bruc3van/agent-buddy-esp32/tools/logo-overrides/README.md

# 官方 logo 覆盖

magpie 的图标来自 lobehub/lobe-icons，个别与官方 logo 不一致，这里放官网原版，`tools/gen_icons.py` 优先使用：

| 文件 | 来源 |
|---|---|
| `pi.svg` | https://pi.dev/logo.svg（Pi 官方，三色像素块） |

ZCode 保持 magpie 原有的大写字母 Z 图标（用户指定）。
