bruc3van/agent-buddy-esp32/docs/images/dupont-hand.jpg

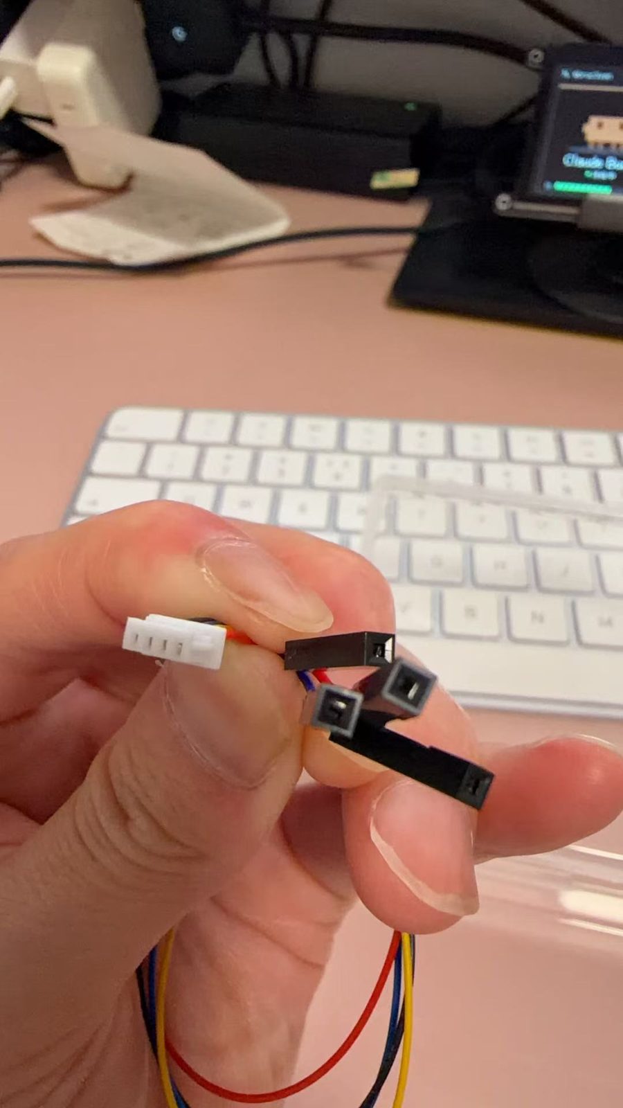
docs/images/dupont-hand.jpg
