bruc3van/agent-buddy-esp32/docs/images/radar-cables.jpg

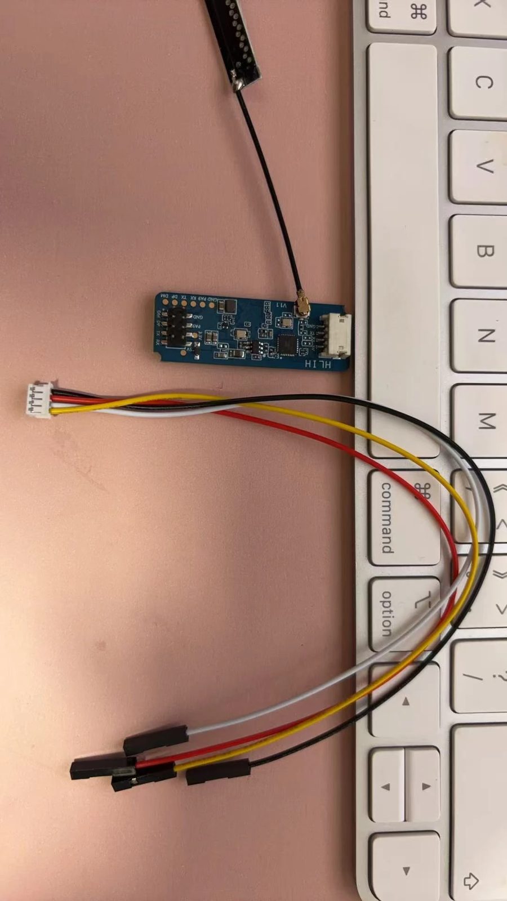
docs/images/radar-cables.jpg
