bruc3van/agent-buddy-esp32/docs/images/v2-magpie-photo.jpg

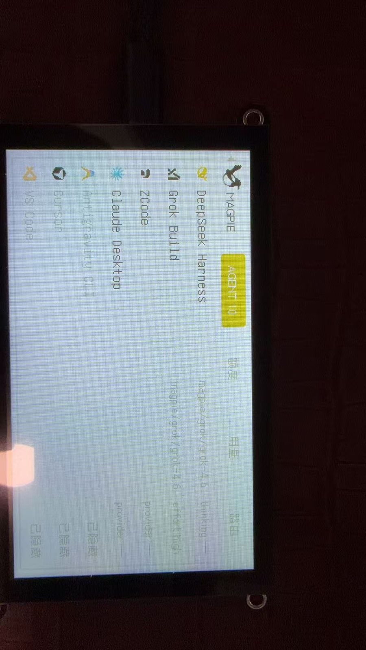
docs/images/v2-magpie-photo.jpg
