bruc3van/agent-buddy-esp32/promo/cover.png

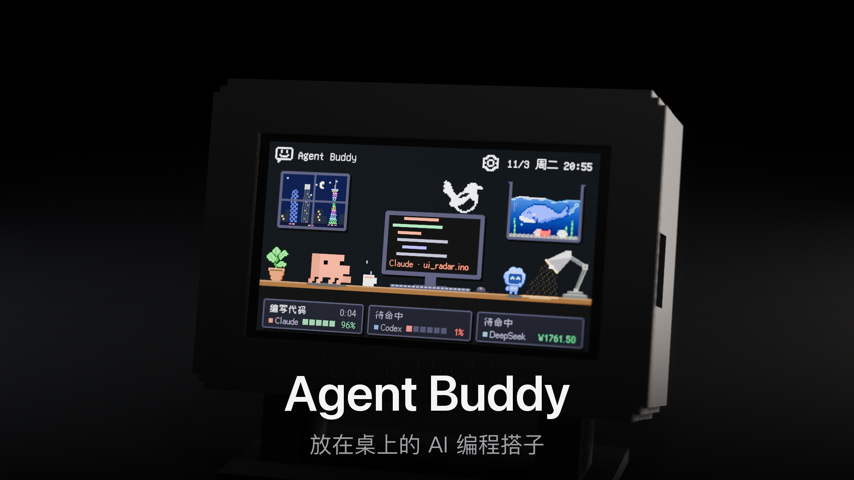
promo/cover.png
