bruc3van/agent-buddy-esp32/case/stl/2-机身-深灰.stl

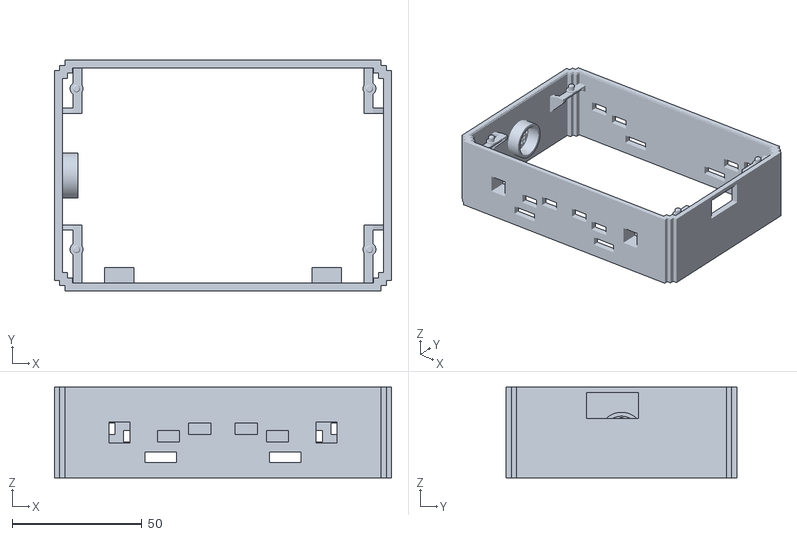
[picture p27: CAD file, 2026-11-05]
case/stl/2-机身-深灰.stl
130.0 x 89.0 x 35.0
