bruc3van/agent-buddy-esp32/case/stl/4-支架-黑.stl

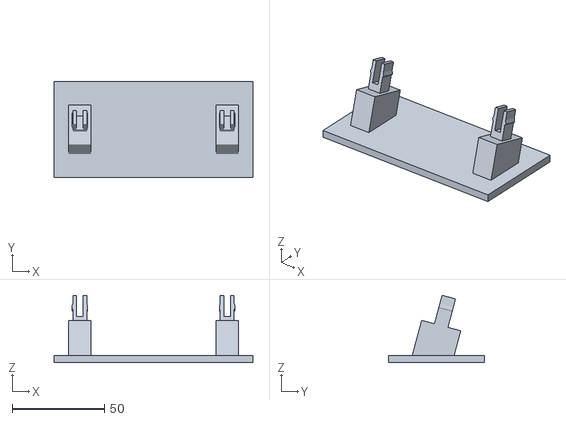
[picture p28: CAD file, 2026-10-31]
case/stl/4-支架-黑.stl
108.0 x 52.0 x 36.6
