bruc3van/agent-buddy-esp32/case/stl/3-后盖-深灰.stl

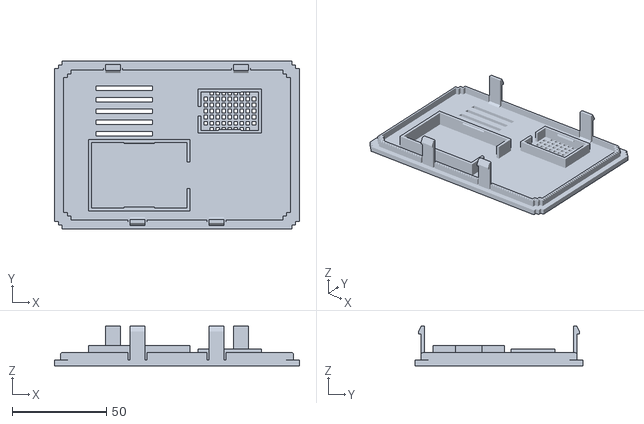
[picture p29: CAD file, 2026-10-31]
case/stl/3-后盖-深灰.stl
130.0 x 89.0 x 21.0
