bruc3van/agent-buddy-esp32/case/stl/1-前框-黑.stl

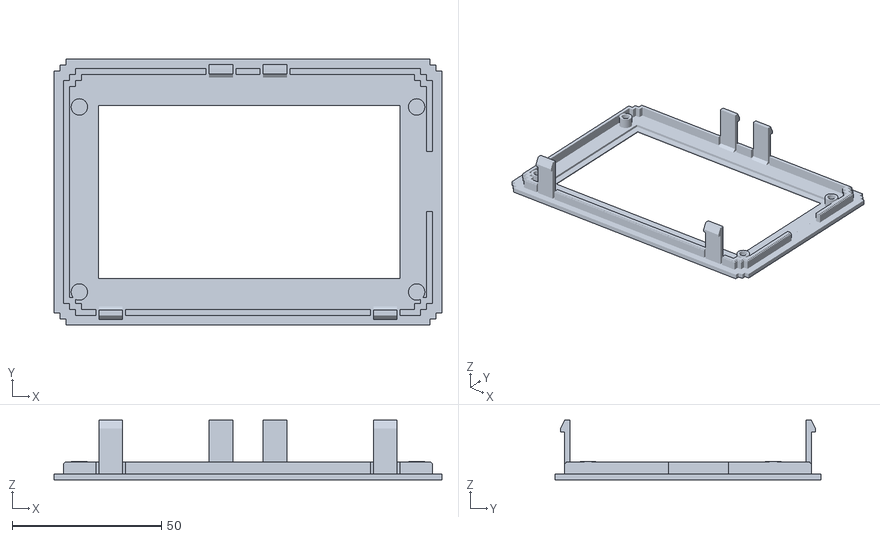
[picture p30: CAD file, 2026-10-31]
case/stl/1-前框-黑.stl
130.0 x 89.0 x 20.0
