bruc3van/agent-buddy-esp32/(list of files, cad)

Other CAD files:
case/外壳预览.blend
