bruc3van/agent-buddy-esp32/case/preview/assembly-back.png

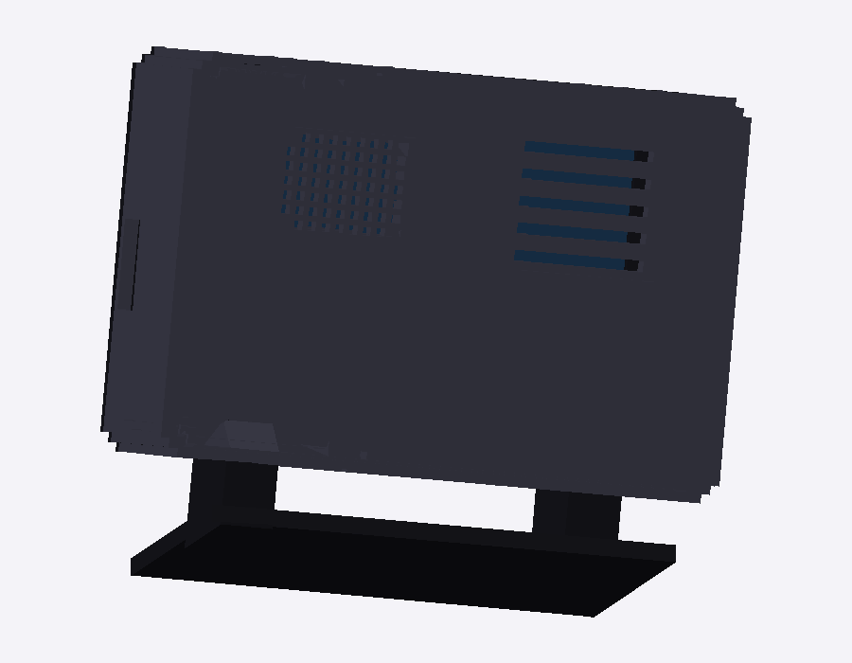
case/preview/assembly-back.png
