bruc3van/agent-buddy-esp32/case/preview/assembly-side.png

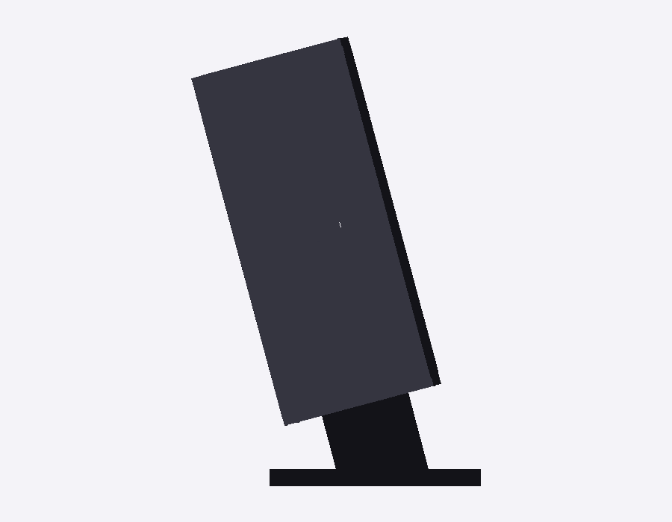
case/preview/assembly-side.png
