bruc3van/agent-buddy-esp32/docs/images/wiring-back.jpg

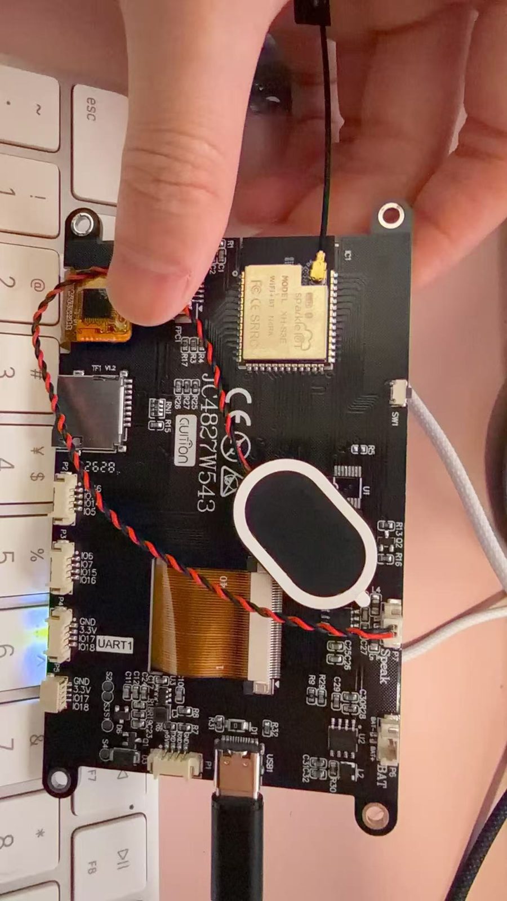
docs/images/wiring-back.jpg
