bruc3van/agent-buddy-esp32/docs/images/wiring-mic.jpg

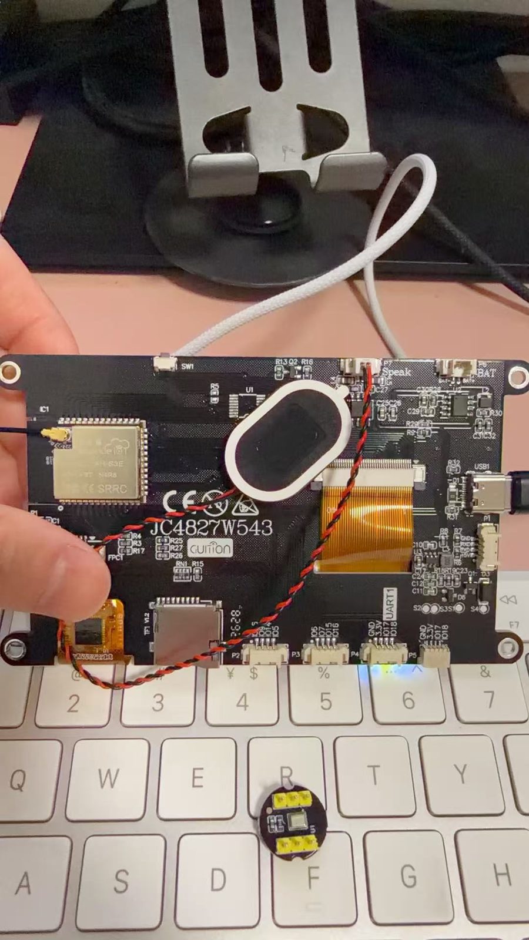
docs/images/wiring-mic.jpg
