bruc3van/agent-buddy-esp32/agent_buddy/QspiFast.cpp

#include "QspiFast.h"

#if defined(ESP32) && (CONFIG_IDF_TARGET_ESP32 || CONFIG_IDF_TARGET_ESP32S2 || CONFIG_IDF_TARGET_ESP32S3 || CONFIG_IDF_TARGET_ESP32C2 || CONFIG_IDF_TARGET_ESP32C3 || CONFIG_IDF_TARGET_ESP32C6 || CONFIG_IDF_TARGET_ESP32H2 || CONFIG_IDF_TARGET_ESP32P4 || CONFIG_IDF_TARGET_ESP32C5)

QspiFast::QspiFast(
    int8_t cs, int8_t sck, int8_t mosi, int8_t miso, int8_t quadwp, int8_t quadhd, bool is_shared_interface /* = false */)
    : _cs(cs), _sck(sck), _mosi(mosi), _miso(miso), _quadwp(quadwp), _quadhd(quadhd), _is_shared_interface(is_shared_interface)
{
}

bool QspiFast::begin(int32_t speed, int8_t dataMode)
{
  // set SPI parameters
  _speed = (speed <= GFX_NOT_DEFINED) ? ESP32QSPI_FREQUENCY : speed;
  _dataMode = (dataMode == GFX_NOT_DEFINED) ? ESP32QSPI_SPI_MODE : dataMode;

  pinMode(_cs, OUTPUT);
  digitalWrite(_cs, HIGH); // disable chip select
#if (CONFIG_IDF_TARGET_ESP32 || CONFIG_IDF_TARGET_ESP32S2 || CONFIG_IDF_TARGET_ESP32S3 || CONFIG_IDF_TARGET_ESP32C6 || CONFIG_IDF_TARGET_ESP32P4 || CONFIG_IDF_TARGET_ESP32C5)
  if (_cs >= 32)
  {
    _csPinMask = digitalPinToBitMask(_cs);
    _csPortSet = (PORTreg_t)GPIO_OUT1_W1TS_REG;
    _csPortClr = (PORTreg_t)GPIO_OUT1_W1TC_REG;
  }
  else if (_cs != GFX_NOT_DEFINED)
  {
    _csPinMask = digitalPinToBitMask(_cs);
    _csPortSet = (PORTreg_t)GPIO_OUT_W1TS_REG;
    _csPortClr = (PORTreg_t)GPIO_OUT_W1TC_REG;
  }
#else
  if (_cs != GFX_NOT_DEFINED)
  {
    _csPinMask = digitalPinToBitMask(_cs);
    _csPortSet = (PORTreg_t)GPIO_OUT_W1TS_REG;
    _csPortClr = (PORTreg_t)GPIO_OUT_W1TC_REG;
  }
#endif

  if (speed != GFX_SKIP_DATABUS_UNDERLAYING_BEGIN)
  {
    spi_bus_config_t buscfg = {
        .mosi_io_num = _mosi,
        .miso_io_num = _miso,
        .sclk_io_num = _sck,
        .quadwp_io_num = _quadwp,
        .quadhd_io_num = _quadhd,
        .data4_io_num = -1,
        .data5_io_num = -1,
        .data6_io_num = -1,
        .data7_io_num = -1,
        .max_transfer_sz = (ESP32QSPI_MAX_PIXELS_AT_ONCE * 16) + 8,
        .flags = SPICOMMON_BUSFLAG_MASTER | SPICOMMON_BUSFLAG_GPIO_PINS,
#if (!defined(ESP_ARDUINO_VERSION_MAJOR)) || (ESP_ARDUINO_VERSION_MAJOR < 3)
    // skip this
#else
        .isr_cpu_id = ESP_INTR_CPU_AFFINITY_AUTO,
#endif
        .intr_flags = 0};
    esp_err_t ret = spi_bus_initialize(ESP32QSPI_SPI_HOST, &buscfg, ESP32QSPI_DMA_CHANNEL);
    if (ret != ESP_OK)
    {
      ESP_ERROR_CHECK(ret);
      return false;
    }
  }

  spi_device_interface_config_t devcfg = {
      .command_bits = 8,
      .address_bits = 24,
      .dummy_bits = 0,
      .mode = (uint8_t)_dataMode,
#if defined(ESP_ARDUINO_VERSION_MAJOR) && ESP_ARDUINO_VERSION_MAJOR >= 3
      .clock_source = SPI_CLK_SRC_DEFAULT,
#endif
      .duty_cycle_pos = 0,
      .cs_ena_pretrans = 0,
      .cs_ena_posttrans = 0,
      .clock_speed_hz = _speed,
      .input_delay_ns = 0,
      .spics_io_num = -1, // avoid use system CS control
      .flags = SPI_DEVICE_HALFDUPLEX,
      .queue_size = 1,
      .pre_cb = nullptr,
      .post_cb = nullptr};
  esp_err_t ret = spi_bus_add_device(ESP32QSPI_SPI_HOST, &devcfg, &_handle);
  if (ret != ESP_OK)
  {
    ESP_ERROR_CHECK(ret);
    return false;
  }

  if (!_is_shared_interface)
  {
    spi_device_acquire_bus(_handle, portMAX_DELAY);
  }

  memset(&_spi_tran_ext, 0, sizeof(_spi_tran_ext));
  _spi_tran = (spi_transaction_t *)&_spi_tran_ext;

  _buffer = (uint8_t *)heap_caps_aligned_alloc(16, ESP32QSPI_MAX_PIXELS_AT_ONCE * 2, MALLOC_CAP_DMA);
  if (!_buffer)
  {
    return false;
  }
  _2nd_buffer = (uint8_t *)heap_caps_aligned_alloc(16, ESP32QSPI_MAX_PIXELS_AT_ONCE * 2, MALLOC_CAP_DMA);
  if (!_2nd_buffer)
  {
    return false;
  }
  for (int i = 0; i < 2; i++)
  {
    _fast[i] = (uint16_t *)heap_caps_aligned_alloc(16, FAST_CHUNK * 2, MALLOC_CAP_DMA | MALLOC_CAP_INTERNAL);
    if (!_fast[i])
    {
      return false;
    }
  }

  return true;
}

void QspiFast::beginWrite()
{
  if (_is_shared_interface)
  {
    spi_device_acquire_bus(_handle, portMAX_DELAY);
  }
}

void QspiFast::endWrite()
{
  if (_is_shared_interface)
  {
    spi_device_release_bus(_handle);
  }
}

void QspiFast::writeCommand(uint8_t c)
{
  CS_LOW();
  _spi_tran_ext.base.flags = SPI_TRANS_MULTILINE_CMD | SPI_TRANS_MULTILINE_ADDR;
  _spi_tran_ext.base.cmd = 0x02;
  _spi_tran_ext.base.addr = ((uint32_t)c) << 8;
  _spi_tran_ext.base.tx_buffer = NULL;
  _spi_tran_ext.base.length = 0;
  POLL_START();
  POLL_END();
  CS_HIGH();
}

void QspiFast::writeCommand16(uint16_t c)
{
  CS_LOW();
  _spi_tran_ext.base.flags = SPI_TRANS_MULTILINE_CMD | SPI_TRANS_MULTILINE_ADDR;
  _spi_tran_ext.base.cmd = 0x02;
  _spi_tran_ext.base.addr = c;
  _spi_tran_ext.base.tx_buffer = NULL;
  _spi_tran_ext.base.length = 0;
  POLL_START();
  POLL_END();
  CS_HIGH();
}

void QspiFast::writeCommandBytes(uint8_t *data, uint32_t len)
{
  CS_LOW();
  uint32_t l;
  while (len)
  {
    l = (len >= (ESP32QSPI_MAX_PIXELS_AT_ONCE << 1)) ? (ESP32QSPI_MAX_PIXELS_AT_ONCE << 1) : len;

    _spi_tran_ext.base.flags = SPI_TRANS_MULTILINE_CMD | SPI_TRANS_MULTILINE_ADDR;
    _spi_tran_ext.base.tx_buffer = data;
    _spi_tran_ext.base.length = l << 3;

    POLL_START();
    POLL_END();

    len -= l;
    data += l;
  }
  CS_HIGH();
}

void QspiFast::write(uint8_t d)
{
  CS_LOW();
  _spi_tran_ext.base.flags = SPI_TRANS_USE_TXDATA | SPI_TRANS_MODE_QIO;
  _spi_tran_ext.base.cmd = 0x32;
  _spi_tran_ext.base.addr = 0x003C00;
  _spi_tran_ext.base.tx_data[0] = d;
  _spi_tran_ext.base.length = 8;
  POLL_START();
  POLL_END();
  CS_HIGH();
}

void QspiFast::write16(uint16_t d)
{
  CS_LOW();
  _spi_tran_ext.base.flags = SPI_TRANS_USE_TXDATA | SPI_TRANS_MODE_QIO;
  _spi_tran_ext.base.cmd = 0x32;
  _spi_tran_ext.base.addr = 0x003C00;
  _spi_tran_ext.base.tx_data[0] = d >> 8;
  _spi_tran_ext.base.tx_data[1] = d;
  _spi_tran_ext.base.length = 16;
  POLL_START();
  POLL_END();
  CS_HIGH();
}

void QspiFast::writeC8D8(uint8_t c, uint8_t d)
{
  CS_LOW();
  _spi_tran_ext.base.flags = SPI_TRANS_USE_TXDATA | SPI_TRANS_MULTILINE_CMD | SPI_TRANS_MULTILINE_ADDR;
  _spi_tran_ext.base.cmd = 0x02;
  _spi_tran_ext.base.addr = ((uint32_t)c) << 8;
  _spi_tran_ext.base.tx_data[0] = d;
  _spi_tran_ext.base.length = 8;
  POLL_START();
  POLL_END();
  CS_HIGH();
}

void QspiFast::writeC8D16(uint8_t c, uint16_t d)
{
  CS_LOW();
  _spi_tran_ext.base.flags = SPI_TRANS_USE_TXDATA | SPI_TRANS_MULTILINE_CMD | SPI_TRANS_MULTILINE_ADDR;
  _spi_tran_ext.base.cmd = 0x02;
  _spi_tran_ext.base.addr = ((uint32_t)c) << 8;
  _spi_tran_ext.base.tx_data[0] = d >> 8;
  _spi_tran_ext.base.tx_data[1] = d;
  _spi_tran_ext.base.length = 16;
  POLL_START();
  POLL_END();
  CS_HIGH();
}

void QspiFast::writeC8D16D16(uint8_t c, uint16_t d1, uint16_t d2)
{
  CS_LOW();
  _spi_tran_ext.base.flags = SPI_TRANS_USE_TXDATA | SPI_TRANS_MULTILINE_CMD | SPI_TRANS_MULTILINE_ADDR;
  _spi_tran_ext.base.cmd = 0x02;
  _spi_tran_ext.base.addr = ((uint32_t)c) << 8;
  _spi_tran_ext.base.tx_data[0] = d1 >> 8;
  _spi_tran_ext.base.tx_data[1] = d1;
  _spi_tran_ext.base.tx_data[2] = d2 >> 8;
  _spi_tran_ext.base.tx_data[3] = d2;
  _spi_tran_ext.base.length = 32;
  POLL_START();
  POLL_END();
  CS_HIGH();
}

void QspiFast::writeC8D16D16Split(uint8_t c, uint16_t d1, uint16_t d2)
{
  CS_LOW();
  _spi_tran_ext.base.flags = SPI_TRANS_USE_TXDATA | SPI_TRANS_MULTILINE_CMD | SPI_TRANS_MULTILINE_ADDR;
  _spi_tran_ext.base.cmd = 0x02;
  _spi_tran_ext.base.addr = ((uint32_t)c) << 8;
  _spi_tran_ext.base.tx_data[0] = d1 >> 8;
  _spi_tran_ext.base.tx_data[1] = d1;
  _spi_tran_ext.base.tx_data[2] = d2 >> 8;
  _spi_tran_ext.base.tx_data[3] = d2;
  _spi_tran_ext.base.length = 32;
  POLL_START();
  POLL_END();
  CS_HIGH();
}

void QspiFast::writeC8Bytes(uint8_t c, uint8_t *data, uint32_t len)
{
  CS_LOW();
  _spi_tran_ext.base.flags = SPI_TRANS_MULTILINE_CMD | SPI_TRANS_MULTILINE_ADDR;
  _spi_tran_ext.base.cmd = 0x02;
  _spi_tran_ext.base.addr = ((uint32_t)c) << 8;
  _spi_tran_ext.base.tx_buffer = data;
  _spi_tran_ext.base.length = len << 3;
  POLL_START();
  POLL_END();
  CS_HIGH();
}

void QspiFast::writeRepeat(uint16_t p, uint32_t len)
{
  bool first_send = true;

  uint16_t bufLen = (len >= ESP32QSPI_MAX_PIXELS_AT_ONCE) ? ESP32QSPI_MAX_PIXELS_AT_ONCE : len;
  int16_t xferLen, l;
  uint32_t c32;
  MSB_32_16_16_SET(c32, p, p);

  l = (bufLen + 1) / 2;
  for (uint32_t i = 0; i < l; i++)
  {
    _buffer32[i] = c32;
  }

  CS_LOW();
  // Issue pixels in blocks from temp buffer
  while (len) // While pixels remain
  {
    xferLen = (bufLen <= len) ? bufLen : len; // How many this pass?

    if (first_send)
    {
      _spi_tran_ext.base.flags = SPI_TRANS_MODE_QIO;
      _spi_tran_ext.base.cmd = 0x32;
      _spi_tran_ext.base.addr = 0x003C00;
      first_send = false;
    }
    else
    {
      _spi_tran_ext.base.flags = SPI_TRANS_MODE_QIO | SPI_TRANS_VARIABLE_CMD |
                                 SPI_TRANS_VARIABLE_ADDR | SPI_TRANS_VARIABLE_DUMMY;
    }
    _spi_tran_ext.base.tx_buffer = _buffer16;
    _spi_tran_ext.base.length = xferLen << 4;

    POLL_START();
    POLL_END();

    len -= xferLen;
  }
  CS_HIGH();
}

// 屏幕校色表（定义在 agent_buddy.ino）：panelGamma == 1 时不校色
extern uint8_t lut5[32], lut6[64];
extern float panelGamma;

// 把一段原生字节序的 RGB565 转成屏幕要的大端序，顺带查表校色；连续同色像素直接复用上一个结果
static void IRAM_ATTR convertChunk(const uint16_t *src, uint16_t *dst, uint32_t n, bool lut)
{
  uint16_t prevIn = src[0] ^ 0xFFFF, prevOut = 0;
  for (uint32_t i = 0; i < n; i++)
  {
    uint16_t c = src[i];
    if (c != prevIn)
    {
      prevIn = c;
      uint16_t o = lut ? (uint16_t)((lut5[c >> 11] << 11) | (lut6[(c >> 5) & 0x3F] << 5) | lut5[c & 0x1F]) : c;
      prevOut = (uint16_t)((o >> 8) | (o << 8));
    }
    dst[i] = prevOut;
  }
}

// 双缓冲异步 DMA：第 k 块在线上发送时，CPU 准备第 k+1 块；块大小 FAST_CHUNK 像素
void QspiFast::writePixels(uint16_t *data, uint32_t len)
{
  CS_LOW();
  bool first = true, inflight = false, lut = panelGamma != 1.0f;
  int cur = 0;
  while (len)
  {
    uint32_t l = len > FAST_CHUNK ? FAST_CHUNK : len;
    convertChunk(data, _fast[cur], l, lut);
    data += l;
    len -= l;
    if (inflight)
    {
      spi_transaction_t *done;
      spi_device_get_trans_result(_handle, &done, portMAX_DELAY);
    }
    spi_transaction_ext_t &t = _fastTr[cur];
    memset(&t, 0, sizeof(t));
    if (first)
    {
      t.base.flags = SPI_TRANS_MODE_QIO;
      t.base.cmd = 0x32;
      t.base.addr = 0x003C00;
      first = false;
    }
    else
    {
      t.base.flags = SPI_TRANS_MODE_QIO | SPI_TRANS_VARIABLE_CMD | SPI_TRANS_VARIABLE_ADDR | SPI_TRANS_VARIABLE_DUMMY;
    }
    t.base.tx_buffer = _fast[cur];
    t.base.length = l << 4;
    spi_device_queue_trans(_handle, (spi_transaction_t *)&t, portMAX_DELAY);
    inflight = true;
    cur ^= 1;
  }
  if (inflight)
  {
    spi_transaction_t *done;
    spi_device_get_trans_result(_handle, &done, portMAX_DELAY);
  }
  CS_HIGH();
}

void QspiFast::batchOperation(const uint8_t *operations, size_t len)
{
  for (size_t i = 0; i < len; ++i)
  {
    uint8_t l = 0;
    switch (operations[i])
    {
    case BEGIN_WRITE:
      beginWrite();
      break;
    case WRITE_COMMAND_8:
      writeCommand(operations[++i]);
      break;
    case WRITE_COMMAND_16:
      _data16.msb = operations[++i];
      _data16.lsb = operations[++i];
      writeCommand16(_data16.value);
      break;
    case WRITE_DATA_8:
      write(operations[++i]);
      break;
    case WRITE_DATA_16:
      _data16.msb = operations[++i];
      _data16.lsb = operations[++i];
      write16(_data16.value);
      break;
    case WRITE_BYTES:
      l = operations[++i];
      memcpy(_buffer, operations + i + 1, l);
      i += l;
      writeBytes(_buffer, l);
      break;
    case WRITE_C8_D8:
      l = operations[++i];
      writeC8D8(l, operations[++i]);
      break;
    case WRITE_C8_D16:
      l = operations[++i];
      _data16.msb = operations[++i];
      _data16.lsb = operations[++i];
      writeC8D16(l, _data16.value);
      break;
    case WRITE_C8_BYTES:
    {
      uint8_t c = operations[++i];
      l = operations[++i];
      memcpy(_buffer, operations + i + 1, l);
      i += l;
      writeC8Bytes(c, _buffer, l);
    }
    break;
    case WRITE_C16_D16:
      break;
    case END_WRITE:
      endWrite();
      break;
    case DELAY:
      delay(operations[++i]);
      break;
    default:
      printf("Unknown operation id at %d: %d\n", i, operations[i]);
      break;
    }
  }
}

void QspiFast::writeBytes(uint8_t *data, uint32_t len)
{
  CS_LOW();
  uint32_t l;
  bool first_send = true;
  while (len)
  {
    l = (len >= (ESP32QSPI_MAX_PIXELS_AT_ONCE << 1)) ? (ESP32QSPI_MAX_PIXELS_AT_ONCE << 1) : len;

    if (first_send)
    {
      _spi_tran_ext.base.flags = SPI_TRANS_MODE_QIO;
      _spi_tran_ext.base.cmd = 0x32;
      _spi_tran_ext.base.addr = 0x003C00;
      first_send = false;
    }
    else
    {
      _spi_tran_ext.base.flags = SPI_TRANS_MODE_QIO | SPI_TRANS_VARIABLE_CMD |
                                 SPI_TRANS_VARIABLE_ADDR | SPI_TRANS_VARIABLE_DUMMY;
    }

    _spi_tran_ext.base.tx_buffer = data;
    _spi_tran_ext.base.length = l << 3;

    POLL_START();
    POLL_END();

    len -= l;
    data += l;
  }
  CS_HIGH();
}

void QspiFast::write16bitBeRGBBitmapR1(uint16_t *bitmap, int16_t w, int16_t h)
{
  if (h > ESP32QSPI_MAX_PIXELS_AT_ONCE)
  {
    log_e("h > ESP32QSPI_MAX_PIXELS_AT_ONCE, h: %d", h);
  }
  else
  {
    CS_LOW();
    uint32_t l = h << 4;
    bool first_send = true;
    uint16_t *p;
    uint16_t *origin_offset = bitmap + ((h - 1) * w);

    for (int16_t i = 0; i < w; i++)
    {
      if (first_send)
      {
        _spi_tran_ext.base.flags = SPI_TRANS_MODE_QIO;
        _spi_tran_ext.base.cmd = 0x32;
        _spi_tran_ext.base.addr = 0x003C00;
        first_send = false;
      }
      else
      {
        POLL_END();
        _spi_tran_ext.base.flags = SPI_TRANS_MODE_QIO | SPI_TRANS_VARIABLE_CMD |
                                   SPI_TRANS_VARIABLE_ADDR | SPI_TRANS_VARIABLE_DUMMY;
      }

      p = origin_offset + i;
      for (int16_t j = 0; j < h; j++)
      {
        _buffer16[j] = *p;
        p -= w;
      }

      _spi_tran_ext.base.tx_buffer = _buffer16;
      _spi_tran_ext.base.length = l;

      POLL_START();
    }
    POLL_END();
    CS_HIGH();
  }
}

void QspiFast::writeIndexedPixels(uint8_t *data, uint16_t *idx, uint32_t len)
{
  CS_LOW();
  uint32_t l, l2;
  uint16_t p1, p2;
  bool first_send = true;
  while (len)
  {
    l = (len > ESP32QSPI_MAX_PIXELS_AT_ONCE) ? ESP32QSPI_MAX_PIXELS_AT_ONCE : len;

    if (first_send)
    {
      _spi_tran_ext.base.flags = SPI_TRANS_MODE_QIO;
      _spi_tran_ext.base.cmd = 0x32;
      _spi_tran_ext.base.addr = 0x003C00;
      first_send = false;
    }
    else
    {
      _spi_tran_ext.base.flags = SPI_TRANS_MODE_QIO | SPI_TRANS_VARIABLE_CMD |
                                 SPI_TRANS_VARIABLE_ADDR | SPI_TRANS_VARIABLE_DUMMY;
    }
    l2 = l >> 1;
    for (uint32_t i = 0; i < l2; ++i)
    {
      p1 = idx[*data++];
      p2 = idx[*data++];
      MSB_32_16_16_SET(_buffer32[i], p1, p2);
    }
    if (l & 1)
    {
      p1 = idx[*data++];
      MSB_16_SET(_buffer16[l - 1], p1);
    }

    _spi_tran_ext.base.tx_buffer = _buffer32;
    _spi_tran_ext.base.length = l << 4;

    POLL_START();
    POLL_END();

    len -= l;
  }
  CS_HIGH();
}

void QspiFast::writeIndexedPixelsDouble(uint8_t *data, uint16_t *idx, uint32_t len)
{
  CS_LOW();
  uint32_t l;
  uint16_t p;
  bool first_send = true;
  while (len)
  {
    l = (len > (ESP32QSPI_MAX_PIXELS_AT_ONCE >> 1)) ? (ESP32QSPI_MAX_PIXELS_AT_ONCE >> 1) : len;

    if (first_send)
    {
      _spi_tran_ext.base.flags = SPI_TRANS_MODE_QIO;
      _spi_tran_ext.base.cmd = 0x32;
      _spi_tran_ext.base.addr = 0x003C00;
      first_send = false;
    }
    else
    {
      _spi_tran_ext.base.flags = SPI_TRANS_MODE_QIO | SPI_TRANS_VARIABLE_CMD |
                                 SPI_TRANS_VARIABLE_ADDR | SPI_TRANS_VARIABLE_DUMMY;
    }
    for (uint32_t i = 0; i < l; ++i)
    {
      p = idx[*data++];
      MSB_32_16_16_SET(_buffer32[i], p, p);
    }

    _spi_tran_ext.base.tx_buffer = _buffer32;
    _spi_tran_ext.base.length = l << 5;

    POLL_START();
    POLL_END();

    len -= l;
  }
  CS_HIGH();
}

void QspiFast::writeYCbCrPixels(uint8_t *yData, uint8_t *cbData, uint8_t *crData, uint16_t w, uint16_t h)
{
  if (w > (ESP32QSPI_MAX_PIXELS_AT_ONCE / 2))
  {
    Arduino_DataBus::writeYCbCrPixels(yData, cbData, crData, w, h);
  }
  else
  {
    bool first_send = true;

    int cols = w >> 1;
    int rows = h >> 1;
    uint8_t *yData2 = yData + w;
    uint16_t *dest = _buffer16;
    uint16_t *dest2 = dest + w;

    uint16_t out_bits = w << 5;

    uint8_t pxCb, pxCr;
    int16_t pxR, pxG, pxB, pxY;

    CS_LOW();
    for (int row = 0; row < rows; ++row)
    {
      for (int col = 0; col < cols; ++col)
      {
        pxCb = *cbData++;
        pxCr = *crData++;
        pxR = CR2R16[pxCr];
        pxG = -CB2G16[pxCb] - CR2G16[pxCr];
        pxB = CB2B16[pxCb];

        pxY = Y2I16[*yData++];
        *dest++ = CLIPRBE[pxY + pxR] | CLIPGBE[pxY + pxG] | CLIPBBE[pxY + pxB];
        pxY = Y2I16[*yData++];
        *dest++ = CLIPRBE[pxY + pxR] | CLIPGBE[pxY + pxG] | CLIPBBE[pxY + pxB];
        pxY = Y2I16[*yData2++];
        *dest2++ = CLIPRBE[pxY + pxR] | CLIPGBE[pxY + pxG] | CLIPBBE[pxY + pxB];
        pxY = Y2I16[*yData2++];
        *dest2++ = CLIPRBE[pxY + pxR] | CLIPGBE[pxY + pxG] | CLIPBBE[pxY + pxB];
      }
      yData += w;
      yData2 += w;

      if (first_send)
      {
        _spi_tran_ext.base.flags = SPI_TRANS_MODE_QIO;
        _spi_tran_ext.base.cmd = 0x32;
        _spi_tran_ext.base.addr = 0x003C00;
        first_send = false;
      }
      else
      {
        POLL_END();
        _spi_tran_ext.base.flags = SPI_TRANS_MODE_QIO | SPI_TRANS_VARIABLE_CMD |
                                   SPI_TRANS_VARIABLE_ADDR | SPI_TRANS_VARIABLE_DUMMY;
      }

      if (row & 1)
      {
        _spi_tran_ext.base.tx_buffer = _2nd_buffer32;
        dest = _buffer16;
      }
      else
      {
        _spi_tran_ext.base.tx_buffer = _buffer32;
        dest = _2nd_buffer16;
      }
      _spi_tran_ext.base.length = out_bits;

      POLL_START();
      dest2 = dest + w;
    }
    POLL_END();
    CS_HIGH();
  }
}
/******** low level bit twiddling **********/

GFX_INLINE void QspiFast::CS_HIGH(void)
{
  *_csPortSet = _csPinMask;
}

GFX_INLINE void QspiFast::CS_LOW(void)
{
  *_csPortClr = _csPinMask;
}

GFX_INLINE void QspiFast::POLL_START()
{
  spi_device_polling_start(_handle, _spi_tran, portMAX_DELAY);
}

GFX_INLINE void QspiFast::POLL_END()
{
  spi_device_polling_end(_handle, portMAX_DELAY);
}

#endif // #if defined(ESP32) && (CONFIG_IDF_TARGET_ESP32 || CONFIG_IDF_TARGET_ESP32S2 || CONFIG_IDF_TARGET_ESP32S3 || CONFIG_IDF_TARGET_ESP32C2 || CONFIG_IDF_TARGET_ESP32C3 || CONFIG_IDF_TARGET_ESP32C6 || CONFIG_IDF_TARGET_ESP32H2 || CONFIG_IDF_TARGET_ESP32P4 || CONFIG_IDF_TARGET_ESP32C5)
