bruc3van/agent-buddy-esp32/agent_buddy/brand_icons.h

// 由 tools/gen_icons.py 生成：magpie 的 Agent / 订阅图标（16px 像素）与 logo 主题色
#pragma once
#include <Arduino.h>

#define BRAND_ICON_SIZE 16
struct BrandIcon { const char *icon; uint16_t color; bool mono; const uint16_t *px; const uint8_t *mask; };
struct BrandAlias { const char *name; const char *icon; };  // Agent 显示名 → 图标名

const uint16_t ic_air_px[256] PROGMEM = {0,0,0,0,0,0,0,0,0,0,0,0,0,0,0,0,0,0,0,0,0,0,0,0,0,0,0,0,0,0,0,0,0,0,0,0,0,0,0,0,0,0,0,0,0,0,0,0,0,0,0,0,0,0,0,0,0,0,0,0,0,0,0,0,0,0,0,0,0,0,0,0,61310,0,0,0,0,0,0,0,0,0,0,0,0,0,0,0,0,0,0,0,0,0,0,0,0,0,61310,61310,0,0,61310,61310,61310,0,0,0,0,61310,0,0,0,0,61310,61310,61310,61310,61310,61310,61310,0,0,61310,61310,61310,61310,61310,0,0,0,0,61310,61310,0,0,61310,0,0,61310,61310,0,0,61310,0,61310,61310,61310,61310,61310,0,0,61310,0,0,61310,61310,0,0,0,61310,61310,0,0,61310,61310,0,0,61310,61310,0,61310,61310,0,0,0,0,0,61310,61310,61310,61310,61310,61310,61310,61310,61310,61310,61310,61310,61310,0,0,0,0,0,0,0,0,0,0,0,0,0,0,0,0,0,0,0,0,0,0,0,0,0,0,0,0,0,0,0,0,0,0,0,0,0,0,0,0,0,0,0,0,0,0,0,0,0,0,0,0,0,0,0,0,0,0,0,0,0,0,0,0,0};
const uint8_t ic_air_mask[32] PROGMEM = {0,0,0,0,0,0,0,0,0,128,0,0,51,132,63,159,12,153,124,152,204,216,63,254,0,0,0,0,0,0,0,0};
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
const uint8_t ic_zed_mask[32] PROGMEM = {255,255,128,2,128,4,159,248,144,17,147,225,151,201,144,137,145,9,147,105,135,201,136,9,31,249,32,1,64,1,255,255};
const uint16_t ic_zhipu_color_px[256] PROGMEM = {0,0,0,0,0,0,0,0,0,0,0,0,0,0,0,0,0,0,0,0,0,0,0,0,0,0,0,0,0,0,0,0,0,0,0,0,0,0,0,15071,15071,0,0,0,0,0,0,0,0,0,0,0,0,0,0,0,0,0,0,0,0,0,0,0,0,0,0,0,0,15071,15135,0,0,17215,13023,0,0,0,0,0,0,0,0,13023,0,13023,15071,0,0,13023,13023,0,15071,0,0,0,0,0,0,0,0,0,0,15071,0,0,0,0,0,0,0,0,0,0,0,15071,15103,0,0,15135,15135,0,0,15103,13023,0,0,0,0,0,0,13023,15103,0,0,15135,15135,0,0,15103,15071,0,0,0,0,0,0,0,0,0,0,15103,0,0,0,0,0,0,0,0,0,0,0,15071,0,13023,15071,0,0,15103,15071,0,15071,0,0,0,0,0,0,0,0,13023,17215,0,0,17215,15071,0,0,0,0,0,0,0,0,0,0,0,0,0,0,0,0,0,0,0,0,0,0,0,0,0,0,0,0,15071,13023,0,0,0,0,0,0,0,0,0,0,0,0,0,0,0,0,0,0,0,0,0,0,0,0,0,0,0,0,0,0,0,0,0,0,0,0,0,0,0};
const uint8_t ic_zhipu_color_mask[32] PROGMEM = {0,0,0,0,1,128,0,0,6,96,22,104,1,0,25,152,25,152,1,0,22,104,6,96,0,0,1,128,0,0,0,0};

const BrandIcon BRAND_ICONS[59] = {
  {"air", 61310, true, ic_air_px, ic_air_mask},
  {"alma", 61310, true, ic_alma_px, ic_alma_mask},
  {"anthropic", 61310, true, ic_anthropic_px, ic_anthropic_mask},
  {"antigravity-color", 15454, false, ic_antigravity_color_px, ic_antigravity_color_mask},
  {"aside", 61310, true, ic_aside_px, ic_aside_mask},
  {"astrbot", 11319, false, ic_astrbot_px, ic_astrbot_mask},
  {"atomcode", 19582, false, ic_atomcode_px, ic_atomcode_mask},
  {"cindy", 53413, false, ic_cindy_px, ic_cindy_mask},
  {"claude-color", 56234, false, ic_claude_color_px, ic_claude_color_mask},
  {"claudecode-color", 56234, false, ic_claudecode_color_px, ic_claudecode_color_mask},
  {"cline", 61310, true, ic_cline_px, ic_cline_mask},
  {"codebuddy-color", 27263, false, ic_codebuddy_color_px, ic_codebuddy_color_mask},
  {"codex-color", 29791, false, ic_codex_color_px, ic_codex_color_mask},
  {"commandcode", 61310, true, ic_commandcode_px, ic_commandcode_mask},
  {"copilot-color", 7388, false, ic_copilot_color_px, ic_copilot_color_mask},
  {"crush", 60029, false, ic_crush_px, ic_crush_mask},
  {"curl", 61310, true, ic_curl_px, ic_curl_mask},
  {"cursor", 61310, true, ic_cursor_px, ic_cursor_mask},
  {"deepseek-color", 19295, false, ic_deepseek_color_px, ic_deepseek_color_mask},
  {"devin", 61310, true, ic_devin_px, ic_devin_mask},
  {"empryo-color", 13103, false, ic_empryo_color_px, ic_empryo_color_mask},
  {"factory", 61310, true, ic_factory_px, ic_factory_mask},
  {"fx", 61310, true, ic_fx_px, ic_fx_mask},
  {"gemini-color", 13375, false, ic_gemini_color_px, ic_gemini_color_mask},
  {"geminicli-color", 9149, false, ic_geminicli_color_px, ic_geminicli_color_mask},
  {"githubcopilot", 61310, true, ic_githubcopilot_px, ic_githubcopilot_mask},
  {"goose", 61310, true, ic_goose_px, ic_goose_mask},
  {"grok", 61310, true, ic_grok_px, ic_grok_mask},
  {"hanako", 61310, true, ic_hanako_px, ic_hanako_mask},
  {"hermes", 61310, true, ic_hermes_px, ic_hermes_mask},
  {"jcode", 61310, true, ic_jcode_px, ic_jcode_mask},
  {"kimi", 61310, true, ic_kimi_px, ic_kimi_mask},
  {"lody", 8851, false, ic_lody_px, ic_lody_mask},
  {"magpie", 61310, true, ic_magpie_px, ic_magpie_mask},
  {"meta-color", 1055, false, ic_meta_color_px, ic_meta_color_mask},
  {"mimocode", 61310, true, ic_mimocode_px, ic_mimocode_mask},
  {"minimax-color", 61963, false, ic_minimax_color_px, ic_minimax_color_mask},
  {"mistermorph-color", 15254, false, ic_mistermorph_color_px, ic_mistermorph_color_mask},
  {"moonshot", 61310, true, ic_moonshot_px, ic_moonshot_mask},
  {"mothx", 716, false, ic_mothx_px, ic_mothx_mask},
  {"omo", 61310, true, ic_omo_px, ic_omo_mask},
  {"omp", 61310, true, ic_omp_px, ic_omp_mask},
  {"openai", 61310, true, ic_openai_px, ic_openai_mask},
  {"openchamber", 61310, true, ic_openchamber_px, ic_openchamber_mask},
  {"opencode", 61310, true, ic_opencode_px, ic_opencode_mask},
  {"pi", 62608, false, ic_pi_px, ic_pi_mask},
  {"prime-agent", 61310, true, ic_prime_agent_px, ic_prime_agent_mask},
  {"qoder", 61310, true, ic_qoder_px, ic_qoder_mask},
  {"qwen-color", 27293, false, ic_qwen_color_px, ic_qwen_color_mask},
  {"raycast", 61310, true, ic_raycast_px, ic_raycast_mask},
  {"reasonix-color", 44137, false, ic_reasonix_color_px, ic_reasonix_color_mask},
  {"snow", 61310, true, ic_snow_px, ic_snow_mask},
  {"stepfun-color", 1151, false, ic_stepfun_color_px, ic_stepfun_color_mask},
  {"t3code", 61310, true, ic_t3code_px, ic_t3code_mask},
  {"vscode", 985, false, ic_vscode_px, ic_vscode_mask},
  {"xai", 61310, true, ic_xai_px, ic_xai_mask},
  {"zcode", 61310, true, ic_zcode_px, ic_zcode_mask},
  {"zed", 61310, true, ic_zed_px, ic_zed_mask},
  {"zhipu-color", 15071, false, ic_zhipu_color_px, ic_zhipu_color_mask},
};
const BrandAlias BRAND_ALIAS[60] = {
  {"Alma", "alma"},
  {"Antigravity CLI", "antigravity-color"},
  {"Aside", "aside"},
  {"AstrBot", "astrbot"},
  {"AtomCode", "atomcode"},
  {"Cindy", "cindy"},
  {"Claude Code", "claudecode-color"},
  {"Claude Desktop", "claude-color"},
  {"Cline", "cline"},
  {"CodeBuddy Code", "codebuddy-color"},
  {"Codex", "codex-color"},
  {"Command Code", "commandcode"},
  {"Copilot (JetBrains)", "githubcopilot"},
  {"Copilot CLI", "githubcopilot"},
  {"Crush", "crush"},
  {"Cursor", "cursor"},
  {"DeepSeek Harness", "deepseek-color"},
  {"Devin", "devin"},
  {"Droid", "factory"},
  {"Empryo", "empryo-color"},
  {"Gemini CLI", "geminicli-color"},
  {"Goose", "goose"},
  {"Grok App", "grok"},
  {"Grok Build", "xai"},
  {"Hermes Agent", "hermes"},
  {"JetBrains Air", "air"},
  {"Kimi Code", "kimi"},
  {"Lody", "lody"},
  {"MiMo Code", "mimocode"},
  {"MiniMax Code", "minimax-color"},
  {"Mister Morph", "mistermorph-color"},
  {"MothX", "mothx"},
  {"Muse Code", "meta-color"},
  {"OmO", "omo"},
  {"OpenChamber", "openchamber"},
  {"OpenCode", "opencode"},
  {"OpenHanako", "hanako"},
  {"PI-Desktop", "pi"},
  {"Pi", "pi"},
  {"Prime Agent", "prime-agent"},
  {"Qoder", "qoder"},
  {"Qwen Code", "qwen-color"},
  {"Raycast", "raycast"},
  {"Reasonix", "reasonix-color"},
  {"Reasonix Studio", "reasonix-color"},
  {"Snow CLI", "snow"},
  {"StepCode", "stepfun-color"},
  {"T3 Code", "t3code"},
  {"VS Code", "vscode"},
  {"VS Code Insiders", "vscode"},
  {"ZCode", "zcode"},
  {"Zed", "zed"},
  {"config.yaml", "goose"},
  {"crush.json", "crush"},
  {"curl", "curl"},
  {"fx", "fx"},
  {"jcode", "jcode"},
  {"magpie", "magpie"},
  {"omp", "omp"},
  {"repl", "aside"},
};
