bruc3van/agent-buddy-esp32/agent_buddy/magpie_wag.h

// 由 tools/gen_wag.py 生成：magpie logo 的 wag 动画（bird-bob / wing-flap / tail-flick），来自 magpie（MIT）
#pragma once
#include <Arduino.h>

#define WAG28_SIZE 28
#define WAG28_FRAMES 23
const uint8_t wag28[23][196] PROGMEM = {
  {0,0,0,0,0,0,0,0,0,0,0,0,0,0,0,0,0,0,0,0,0,16,0,0,0,0,0,0,121,0,0,0,1,148,0,63,64,0,0,31,254,0,175,128,0,0,63,255,228,187,208,0,0,191,255,233,63,240,0,1,255,254,0,111,244,0,2,255,254,0,123,252,0,11,171,254,0,31,254,0,100,3,255,0,2,255,129,128,6,255,64,0,127,253,0,29,255,128,0,47,244,6,244,191,128,0,10,229,191,224,47,128,0,6,255,255,128,1,128,0,11,255,254,0,1,64,0,31,255,228,0,1,0,0,43,254,64,0,1,0,0,6,164,0,0,4,0,0,0,40,0,0,20,0,0,0,9,0,0,80,0,0,0,1,144,5,0,0,0,0,0,22,144,0,0,0,0,0,0,0,0,0,0,0,0,0,0,0,0,0,0,0,0,0,0,0},
  {0,0,0,0,0,0,0,0,0,0,0,0,0,0,0,0,0,0,0,0,0,36,0,0,0,0,0,0,46,0,0,0,6,144,0,47,128,0,0,47,253,0,111,208,0,0,191,255,228,123,224,0,0,255,255,148,46,240,0,2,255,253,0,175,248,0,7,255,253,0,62,252,0,27,175,253,0,31,190,0,100,7,255,0,2,255,65,64,11,255,64,0,191,233,0,105,255,128,0,47,245,107,240,191,128,0,15,255,255,208,47,128,0,31,255,254,0,1,64,0,127,255,244,0,1,64,0,107,254,64,0,2,0,0,1,144,0,0,1,0,0,5,84,0,0,4,0,0,0,116,0,0,16,0,0,0,9,0,0,80,0,0,0,1,80,5,0,0,0,0,0,21,144,0,0,0,0,0,0,0,0,0,0,0,0,0,0,0,0,0,0,0,0,0,0,0},
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
};

#define WAG100_SIZE 100
#define WAG100_FRAMES 23
const uint8_t wag100[23][2500] PROGMEM = {
  {0,0,0,0,0,0,0,0,0,0,0,0,0,0,0,0,0,0,0,0,0,0,0,0,0,0,0,0,0,0,0,0,0,0,0,0,0,0,0,0,0,0,0,0,0,0,0,0,0,0,0,0,0,0,0,0,0,0,0,0,0,0,0,0,0,0,0,0,0,0,0,0,0,0,0,0,0,0,0,0,0,0,0,0,0,0,0,0,0,0,0,0,0,0,0,0,0,0,0,0,0,0,0,0,0,0,0,0,0,0,0,0,0,0,0,0,0,0,0,0,0,0,0,0,0,0,0,0,0,0,0,0,0,0,0,0,0,0,0,0,0,0,0,0,0,0,0,0,0,0,0,0,0,0,0,0,0,0,0,0,0,0,0,0,0,0,0,0,0,0,0,0,0,0,0,0,0,0,0,0,0,0,0,0,0,0,0,0,0,0,0,0,0,0,0,0,0,0,0,0,0,0,0,0,0,0,0,0,0,0,0,0,0,0,0,0,0,0,0,0,0,0,0,0,0,0,0,0,0,0,0,0,0,0,0,0,0,0,0,0,0,0,0,0,0,0,0,0,0,0,0,0,0,0,0,0,0,0,0,0,0,0,0,0,0,0,0,0,0,0,0,0,0,0,0,0,0,0,0,0,0,0,0,0,0,0,0,0,0,0,0,0,0,0,0,0,0,0,0,0,1,64,0,0,0,0,0,0,0,0,0,0,0,0,0,0,0,0,0,0,0,0,0,0,0,3,248,0,0,0,0,0,0,0,0,0,0,0,0,0,0,0,0,0,0,0,0,0,0,0,7,255,128,0,0,0,0,0,0,0,0,0,0,0,0,0,0,0,0,0,0,0,0,0,0,7,255,228,0,0,0,0,0,0,0,0,0,0,0,0,0,0,1,85,0,0,0,0,0,0,7,255,253,0,0,0,0,0,0,0,0,0,0,0,0,0,0,175,255,249,0,0,0,0,0,7,255,255,64,0,0,0,0,0,0,0,0,0,0,0,0,11,255,255,255,208,0,0,0,0,3,255,255,224,0,0,0,0,0,0,0,0,0,0,0,0,127,255,255,255,248,0,0,0,0,2,255,255,244,0,0,0,0,0,0,0,0,0,0,0,2,255,255,255,255,255,64,0,0,0,1,255,255,253,0,0,0,0,0,0,0,0,0,0,0,11,255,255,255,255,255,208,0,0,0,0,191,255,255,64,0,0,0,0,0,0,0,0,0,0,31,255,255,255,255,255,249,0,0,0,40,63,255,255,128,0,0,0,0,0,0,0,0,0,0,127,255,255,255,255,255,255,249,64,0,46,31,255,255,224,0,0,0,0,0,0,0,0,0,0,255,255,255,255,255,255,255,255,249,0,47,139,255,255,244,0,0,0,0,0,0,0,0,0,1,255,255,255,255,255,255,255,255,255,144,47,226,255,255,252,0,0,0,0,0,0,0,0,0,3,255,255,255,255,255,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
0,0,0,0,0,0,0,0,0,0,0,0,0,0,0,0,0,0,0,0,0,0,0,0,0,0,0,0,0,0,0,0,0,0,0,0,0,0,0,0,0,0,0,0,0,0,0,0,0,0,0,0,0,0,0,0,0,0,0,0,0,0,0,0,0,0,0,0,0,0,0,0,0,0,0,0,0,0,0,0,0,0,0,0,0,0,0,0,0,0,0,0,0,0,0,0,0,0,0,0,0,0,0,0,0,0,0,0,0,0,0,0,0,0,0,0,0,0,0,0,0,0,0,0,0,0,0,0,0,0,0,0,0,0,0,0,0,0,0,0,0,0,0,0,0,0,0,0,0,0,0,0,0,0,0,0,0,0,0,0,0,0,0,0,0,0,0,0,0,0,0,0,0,0,0,0,0,0,0,0,0,0,0},
  {0,0,0,0,0,0,0,0,0,0,0,0,0,0,0,0,0,0,0,0,0,0,0,0,0,0,0,0,0,0,0,0,0,0,0,0,0,0,0,0,0,0,0,0,0,0,0,0,0,0,0,0,0,0,0,0,0,0,0,0,0,0,0,0,0,0,0,0,0,0,0,0,0,0,0,0,0,0,0,0,0,0,0,0,0,0,0,0,0,0,0,0,0,0,0,0,0,0,0,0,0,0,0,0,0,0,0,0,0,0,0,0,0,0,0,0,0,0,0,0,0,0,0,0,0,0,0,0,0,0,0,0,0,0,0,0,0,0,0,0,0,0,0,0,0,0,0,0,0,0,0,0,0,0,0,0,0,0,0,0,0,0,0,0,0,0,0,0,0,0,0,0,0,0,0,0,0,0,0,0,0,0,0,0,0,0,0,0,0,0,0,0,0,0,0,0,0,0,0,0,0,0,0,0,0,0,0,0,0,0,0,0,0,0,0,0,0,0,0,0,0,0,0,0,0,0,0,0,0,0,0,0,0,0,0,0,0,0,0,0,0,0,0,0,0,0,0,0,0,0,0,0,0,0,0,0,0,0,0,0,0,0,0,0,0,0,0,0,0,0,0,0,0,0,0,0,36,0,0,0,0,0,0,0,0,0,0,0,0,0,0,0,0,0,0,0,0,0,0,0,0,191,64,0,0,0,0,0,0,0,0,0,0,0,0,0,0,0,0,0,0,0,0,0,0,0,191,224,0,0,0,0,0,0,0,0,0,0,0,0,0,0,0,0,0,0,0,0,0,0,0,191,253,0,0,0,0,0,0,0,0,0,0,0,0,0,0,0,0,0,0,0,0,0,0,0,255,255,64,0,0,0,0,0,0,0,0,0,0,0,0,0,26,165,64,0,0,0,0,0,0,255,255,208,0,0,0,0,0,0,0,0,0,0,0,0,6,255,255,248,0,0,0,0,0,0,191,255,244,0,0,0,0,0,0,0,0,0,0,0,0,127,255,255,255,64,0,0,0,0,0,127,255,253,0,0,0,0,0,0,0,0,0,0,0,2,255,255,255,255,244,0,0,0,0,0,63,255,255,0,0,0,0,0,0,0,0,0,0,0,15,255,255,255,255,253,0,0,0,0,4,47,255,255,128,0,0,0,0,0,0,0,0,0,0,47,255,255,255,255,255,128,0,0,0,10,15,255,255,208,0,0,0,0,0,0,0,0,0,0,191,255,255,255,255,255,250,80,0,0,11,135,255,255,240,0,0,0,0,0,0,0,0,0,2,255,255,255,255,255,255,255,255,144,0,11,226,255,255,248,0,0,0,0,0,0,0,0,0,3,255,255,255,255,255,255,255,255,253,0,15,249,255,255,253,0,0,0,0,0,0,0,0,0,11,255,255,255,255,255,255,255,255,255,128,11,254,127,255,254,0,0,0,0,0,0,0,0,0,31,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
,0,0,0,0,0,0,0,0,0,0,0,0,0,0,0,0,0,0,0,0,0,0,0,0,0,0,0,0,0,0,0,0,0,0,0,0,0,0,0,0,0,0,0,0,0,0,0,0,0,0,0,0,0,0,0,0,0,0,0,0,0,0,0,0,0,0,0,0,0,0,0,0,0,0,0,0,0,0,0,0,0,0,0,0,0,0,0,0,0,0,0,0,0,0,0,0,0,0,0,0,0,0,0,0,0,0,0,0,0,0,0,0,0,0,0,0,0,0,0,0,0,0,0,0,0,0,0,0,0,0,0,0,0,0,0,0,0,0,0,0,0,0,0,0,0,0,0,0,0,0,0,0,0,0,0,0,0,0,0,0,0,0,0,0,0,0,0,0,0,0,0,0,0,0,0},
  {0,0,0,0,0,0,0,0,0,0,0,0,0,0,0,0,0,0,0,0,0,0,0,0,0,0,0,0,0,0,0,0,0,0,0,0,0,0,0,0,0,0,0,0,0,0,0,0,0,0,0,0,0,0,0,0,0,0,0,0,0,0,0,0,0,0,0,0,0,0,0,0,0,0,0,0,0,0,0,0,0,0,0,0,0,0,0,0,0,0,0,0,0,0,0,0,0,0,0,0,0,0,0,0,0,0,0,0,0,0,0,0,0,0,0,0,0,0,0,0,0,0,0,0,0,0,0,0,0,0,0,0,0,0,0,0,0,0,0,0,0,0,0,0,0,0,0,0,0,0,0,0,0,0,0,0,0,0,0,0,0,0,0,0,0,0,0,0,0,0,0,0,0,0,0,0,0,0,0,0,0,0,0,0,0,0,0,0,0,0,0,0,0,0,0,0,0,0,0,0,0,0,0,0,0,0,0,0,0,0,0,0,0,0,0,0,0,0,0,0,0,0,0,0,0,0,0,0,0,0,0,0,0,0,0,0,0,0,0,0,0,0,0,0,0,0,0,0,0,0,0,2,208,0,0,0,0,0,0,0,0,0,0,0,0,0,0,0,0,0,0,0,0,0,0,0,3,249,0,0,0,0,0,0,0,0,0,0,0,0,0,0,0,0,0,0,0,0,0,0,0,7,255,64,0,0,0,0,0,0,0,0,0,0,0,0,0,0,0,0,0,0,0,0,0,0,11,255,208,0,0,0,0,0,0,0,0,0,0,0,0,0,0,0,0,0,0,0,0,0,0,11,255,244,0,0,0,0,0,0,0,0,0,0,0,0,0,4,0,0,0,0,0,0,0,0,11,255,253,0,0,0,0,0,0,0,0,0,0,0,0,6,255,249,0,0,0,0,0,0,0,11,255,255,0,0,0,0,0,0,0,0,0,0,0,1,191,255,255,224,0,0,0,0,0,0,7,255,255,128,0,0,0,0,0,0,0,0,0,0,11,255,255,255,253,0,0,0,0,0,0,3,255,255,224,0,0,0,0,0,0,0,0,0,0,127,255,255,255,255,144,0,0,0,0,0,146,255,255,244,0,0,0,0,0,0,0,0,0,1,255,255,255,255,255,244,0,0,0,0,0,240,255,255,248,0,0,0,0,0,0,0,0,0,7,255,255,255,255,255,254,85,0,0,0,1,248,191,255,253,0,0,0,0,0,0,0,0,0,11,255,255,255,255,255,255,255,233,0,0,1,254,63,255,254,0,0,0,0,0,0,0,0,0,47,255,255,255,255,255,255,255,255,208,0,1,255,111,255,255,64,0,0,0,0,0,0,0,0,63,255,255,255,255,255,255,255,255,253,0,1,255,207,255,255,128,0,0,0,0,0,0,0,0,191,255,255,255,255,255,255,255,255,164,0,0,255,231,255,255,192,0,0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
,0,0,0,0,0,0,0,0,0,0,0,0,0,0,0,0,0,0,0,0,0,0,0,0,0,0,0,0,0,0,0,0,0,0,0,0,0,0,0,0,0,0,0,0,0,0,0,0,0,0,0,0,0,0,0,0,0,0,0,0,0,0,0,0,0,0,0,0,0,0,0,0,0,0,0,0,0,0,0,0,0,0,0,0,0,0,0,0,0,0,0,0,0,0,0,0,0,0,0,0,0,0,0,0,0,0,0,0,0,0,0,0,0,0,0,0,0,0,0,0,0,0,0,0,0,0,0,0,0,0,0,0,0,0,0,0,0,0,0,0,0,0,0,0,0,0,0,0,0,0,0,0,0,0,0,0,0,0,0,0,0,0,0,0,0,0,0,0,0},
  {0,0,0,0,0,0,0,0,0,0,0,0,0,0,0,0,0,0,0,0,0,0,0,0,0,0,0,0,0,0,0,0,0,0,0,0,0,0,0,0,0,0,0,0,0,0,0,0,0,0,0,0,0,0,0,0,0,0,0,0,0,0,0,0,0,0,0,0,0,0,0,0,0,0,0,0,0,0,0,0,0,0,0,0,0,0,0,0,0,0,0,0,0,0,0,0,0,0,0,0,0,0,0,0,0,0,0,0,0,0,0,0,0,0,0,0,0,0,0,0,0,0,0,0,0,0,0,0,0,0,0,0,0,0,0,0,0,0,0,0,0,0,0,0,0,0,0,0,0,0,0,0,0,0,0,0,0,0,0,0,0,0,0,0,0,0,0,0,0,0,0,0,0,0,0,0,0,0,0,0,0,0,0,0,0,0,0,0,0,0,0,0,0,0,0,0,0,0,0,0,0,0,0,0,0,0,0,0,0,0,0,0,0,0,0,0,0,0,0,0,0,0,0,0,0,0,0,16,0,0,0,0,0,0,0,0,0,0,0,0,0,0,0,0,0,0,0,0,0,0,0,0,189,0,0,0,0,0,0,0,0,0,0,0,0,0,0,0,0,0,0,0,0,0,0,0,0,255,128,0,0,0,0,0,0,0,0,0,0,0,0,0,0,0,0,0,0,0,0,0,0,1,255,224,0,0,0,0,0,0,0,0,0,0,0,0,0,0,0,0,0,0,0,0,0,0,2,255,248,0,0,0,0,0,0,0,0,0,0,0,0,0,0,0,0,0,0,0,0,0,0,2,255,254,0,0,0,0,0,0,0,0,0,0,0,0,0,85,0,0,0,0,0,0,0,0,2,255,255,64,0,0,0,0,0,0,0,0,0,0,0,111,255,249,0,0,0,0,0,0,0,2,255,255,208,0,0,0,0,0,0,0,0,0,0,7,255,255,255,208,0,0,0,0,0,0,0,255,255,224,0,0,0,0,0,0,0,0,0,0,47,255,255,255,249,0,0,0,0,0,0,16,255,255,248,0,0,0,0,0,0,0,0,0,1,255,255,255,255,255,64,0,0,0,0,0,120,127,255,252,0,0,0,0,0,0,0,0,0,7,255,255,255,255,255,224,0,0,0,0,0,125,63,255,254,0,0,0,0,0,0,0,0,0,15,255,255,255,255,255,255,169,64,0,0,0,191,47,255,255,0,0,0,0,0,0,0,0,0,47,255,255,255,255,255,255,255,249,0,0,0,191,143,255,255,128,0,0,0,0,0,0,0,0,191,255,255,255,255,255,255,255,255,208,0,0,191,219,255,255,192,0,0,0,0,0,0,0,0,255,255,255,255,255,255,255,255,255,244,0,0,191,243,255,255,208,0,0,0,0,0,0,0,2,255,255,255,255,255,255,255,255,233,0,0,0,127,250,255,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
0,0,0,0,0,0,0,0,0,0,0,0,0,0,0,0,0,0,0,0,0,0,0,0,0,0,0,0,0,0,0,0,0,0,0,0,0,0,0,0,0,0,0,0,0,0,0,0,0,0,0,0,0,0,0,0,0,0,0,0,0,0,0,0,0,0,0,0,0,0,0,0,0,0,0,0,0,0,0,0,0,0,0,0,0,0,0,0,0,0,0,0,0,0,0,0,0,0,0,0,0,0,0,0,0,0,0,0,0,0,0,0,0,0,0,0,0,0,0,0,0,0,0,0,0,0,0,0,0,0,0,0,0,0,0,0,0,0,0,0,0,0,0,0,0,0,0,0,0,0,0,0,0,0,0,0,0,0,0,0,0,0,0,0,0,0,0,0,0,0,0,0,0,0},
  {0,0,0,0,0,0,0,0,0,0,0,0,0,0,0,0,0,0,0,0,0,0,0,0,0,0,0,0,0,0,0,0,0,0,0,0,0,0,0,0,0,0,0,0,0,0,0,0,0,0,0,0,0,0,0,0,0,0,0,0,0,0,0,0,0,0,0,0,0,0,0,0,0,0,0,0,0,0,0,0,0,0,0,0,0,0,0,0,0,0,0,0,0,0,0,0,0,0,0,0,0,0,0,0,0,0,0,0,0,0,0,0,0,0,0,0,0,0,0,0,0,0,0,0,0,0,0,0,0,0,0,0,0,0,0,0,0,0,0,0,0,0,0,0,0,0,0,0,0,0,0,0,0,0,0,0,0,0,0,0,0,0,0,0,0,0,0,0,0,0,0,0,0,0,0,0,0,0,0,0,0,0,0,0,0,0,0,0,0,0,0,0,0,0,0,0,0,0,0,0,0,0,0,0,0,0,0,0,0,0,0,0,0,0,0,0,0,0,0,0,0,0,0,0,0,0,0,20,0,0,0,0,0,0,0,0,0,0,0,0,0,0,0,0,0,0,0,0,0,0,0,0,126,0,0,0,0,0,0,0,0,0,0,0,0,0,0,0,0,0,0,0,0,0,0,0,0,191,144,0,0,0,0,0,0,0,0,0,0,0,0,0,0,0,0,0,0,0,0,0,0,0,255,244,0,0,0,0,0,0,0,0,0,0,0,0,0,0,0,0,0,0,0,0,0,0,1,255,252,0,0,0,0,0,0,0,0,0,0,0,0,0,0,0,0,0,0,0,0,0,0,1,255,254,0,0,0,0,0,0,0,0,0,0,0,0,1,85,0,0,0,0,0,0,0,0,1,255,255,128,0,0,0,0,0,0,0,0,0,0,0,111,255,249,0,0,0,0,0,0,0,1,255,255,208,0,0,0,0,0,0,0,0,0,0,7,255,255,255,144,0,0,0,0,0,0,0,255,255,240,0,0,0,0,0,0,0,0,0,0,127,255,255,255,248,0,0,0,0,0,0,32,191,255,248,0,0,0,0,0,0,0,0,0,1,255,255,255,255,255,64,0,0,0,0,0,56,127,255,253,0,0,0,0,0,0,0,0,0,7,255,255,255,255,255,224,0,0,0,0,0,62,47,255,254,0,0,0,0,0,0,0,0,0,31,255,255,255,255,255,255,233,64,0,0,0,127,95,255,255,64,0,0,0,0,0,0,0,0,63,255,255,255,255,255,255,255,249,0,0,0,191,207,255,255,128,0,0,0,0,0,0,0,0,191,255,255,255,255,255,255,255,255,208,0,0,191,231,255,255,192,0,0,0,0,0,0,0,1,255,255,255,255,255,255,255,255,255,228,0,0,127,243,255,255,224,0,0,0,0,0,0,0,2,255,255,255,255,255,255,255,255,229,0,0,0,127,249,255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
,0,0,0,0,0,0,0,0,0,0,0,0,0,0,0,0,0,0,0,0,0,0,0,0,0,0,0,0,0,0,0,0,0,0,0,0,0,0,0,0,0,0,0,0,0,0,0,0,0,0,0,0,0,0,0,0,0,0,0,0,0,0,0,0,0,0,0,0,0,0,0,0,0,0,0,0,0,0,0,0,0,0,0,0,0,0,0,0,0,0,0,0,0,0,0,0,0,0,0,0,0,0,0,0,0,0,0,0,0,0,0,0,0,0,0,0,0,0,0,0,0,0,0,0,0,0,0,0,0,0,0,0,0,0,0,0,0,0,0,0,0,0,0,0,0,0,0,0,0,0,0,0,0,0,0,0,0,0,0,0,0,0,0,0,0,0,0,0,0,0,0,0,0,0,0,0,0,0,0,0,0,0,0,0,0,0,0,0,0,0,0,0,0},
  {0,0,0,0,0,0,0,0,0,0,0,0,0,0,0,0,0,0,0,0,0,0,0,0,0,0,0,0,0,0,0,0,0,0,0,0,0,0,0,0,0,0,0,0,0,0,0,0,0,0,0,0,0,0,0,0,0,0,0,0,0,0,0,0,0,0,0,0,0,0,0,0,0,0,0,0,0,0,0,0,0,0,0,0,0,0,0,0,0,0,0,0,0,0,0,0,0,0,0,0,0,0,0,0,0,0,0,0,0,0,0,0,0,0,0,0,0,0,0,0,0,0,0,0,0,0,0,0,0,0,0,0,0,0,0,0,0,0,0,0,0,0,0,0,0,0,0,0,0,0,0,0,0,0,0,0,0,0,0,0,0,0,0,0,0,0,0,0,0,0,0,0,0,0,0,0,0,0,0,0,0,0,0,0,0,0,0,0,0,0,0,0,0,0,0,0,0,0,0,0,0,0,0,0,0,0,0,0,0,0,0,0,0,0,0,0,0,0,0,0,0,0,0,0,0,0,0,0,0,0,0,0,0,0,0,0,0,0,0,0,0,0,0,0,0,0,0,0,0,0,0,0,0,0,0,0,0,0,0,0,0,0,0,0,0,0,0,0,0,0,0,0,0,0,0,0,45,0,0,0,0,0,0,0,0,0,0,0,0,0,0,0,0,0,0,0,0,0,0,0,0,63,208,0,0,0,0,0,0,0,0,0,0,0,0,0,0,0,0,0,0,0,0,0,0,0,63,248,0,0,0,0,0,0,0,0,0,0,0,0,0,0,0,0,0,0,0,0,0,0,0,127,254,0,0,0,0,0,0,0,0,0,0,0,0,0,0,0,0,0,0,0,0,0,0,0,127,255,128,0,0,0,0,0,0,0,0,0,0,0,0,6,255,233,0,0,0,0,0,0,0,127,255,224,0,0,0,0,0,0,0,0,0,0,0,0,191,255,255,224,0,0,0,0,0,0,63,255,248,0,0,0,0,0,0,0,0,0,0,0,7,255,255,255,254,0,0,0,0,0,0,63,255,254,0,0,0,0,0,0,0,0,0,0,0,47,255,255,255,255,208,0,0,0,0,0,31,255,255,64,0,0,0,0,0,0,0,0,0,0,191,255,255,255,255,248,0,0,0,0,6,15,255,255,192,0,0,0,0,0,0,0,0,0,2,255,255,255,255,255,254,84,0,0,0,11,139,255,255,224,0,0,0,0,0,0,0,0,0,11,255,255,255,255,255,255,255,229,0,0,11,211,255,255,244,0,0,0,0,0,0,0,0,0,31,255,255,255,255,255,255,255,255,208,0,11,245,255,255,248,0,0,0,0,0,0,0,0,0,47,255,255,255,255,255,255,255,255,253,0,11,253,191,255,253,0,0,0,0,0,0,0,0,0,127,255,255,255,255,255,255,255,255,233,0,11,254,63,255,254,0,0,0,0,0,0,0,0,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
,0,0,0,0,0,0,0,0,0,0,0,0,0,0,0,0,0,0,0,0,0,0,0,0,0,0,0,0,0,0,0,0,0,0,0,0,0,0,0,0,0,0,0,0,0,0,0,0,0,0,0,0,0,0,0,0,0,0,0,0,0,0,0,0,0,0,0,0,0,0,0,0,0,0,0,0,0,0,0,0,0,0,0,0,0,0,0,0,0,0,0,0,0,0,0,0,0,0,0,0,0,0,0,0,0,0,0,0,0,0,0,0,0,0,0,0,0,0,0,0,0,0,0,0,0,0,0,0,0,0,0,0,0,0,0,0,0,0,0,0,0,0,0,0,0,0,0,0,0,0,0,0,0,0,0,0,0,0,0,0,0,0,0,0,0,0,0,0,0,0,0,0,0,0,0,0,0,0,0,0,0,0,0,0,0,0},
  {0,0,0,0,0,0,0,0,0,0,0,0,0,0,0,0,0,0,0,0,0,0,0,0,0,0,0,0,0,0,0,0,0,0,0,0,0,0,0,0,0,0,0,0,0,0,0,0,0,0,0,0,0,0,0,0,0,0,0,0,0,0,0,0,0,0,0,0,0,0,0,0,0,0,0,0,0,0,0,0,0,0,0,0,0,0,0,0,0,0,0,0,0,0,0,0,0,0,0,0,0,0,0,0,0,0,0,0,0,0,0,0,0,0,0,0,0,0,0,0,0,0,0,0,0,0,0,0,0,0,0,0,0,0,0,0,0,0,0,0,0,0,0,0,0,0,0,0,0,0,0,0,0,0,0,0,0,0,0,0,0,0,0,0,0,0,0,0,0,0,0,0,0,0,0,0,0,0,0,0,0,0,0,0,0,0,0,0,0,0,0,0,0,0,0,0,0,0,0,0,0,0,0,0,0,0,0,0,0,0,0,0,0,0,0,0,0,0,0,0,0,0,0,0,0,0,0,0,0,0,0,0,0,0,0,0,0,0,0,0,0,0,0,0,0,0,0,0,0,0,0,0,0,0,0,0,0,0,0,0,0,0,0,0,0,0,0,0,0,0,0,0,0,0,0,0,0,0,0,0,0,0,0,0,0,0,0,0,0,0,0,0,0,0,0,0,0,0,0,0,0,0,0,0,0,0,0,0,0,0,0,0,0,0,0,0,0,0,0,0,0,0,0,0,0,5,0,0,0,0,0,0,0,0,0,0,0,0,0,0,0,0,0,0,0,0,0,0,0,0,31,224,0,0,0,0,0,0,0,0,0,0,0,0,0,0,0,0,0,0,0,0,0,0,0,31,254,0,0,0,0,0,0,0,0,0,0,0,0,0,0,0,5,85,64,0,0,0,0,0,47,255,208,0,0,0,0,0,0,0,0,0,0,0,0,0,1,191,255,249,0,0,0,0,0,47,255,244,0,0,0,0,0,0,0,0,0,0,0,0,0,27,255,255,255,144,0,0,0,0,31,255,254,0,0,0,0,0,0,0,0,0,0,0,0,0,191,255,255,255,248,0,0,0,0,15,255,255,128,0,0,0,0,0,0,0,0,0,0,0,2,255,255,255,255,255,64,0,0,0,11,255,255,224,0,0,0,0,0,0,0,0,0,0,0,11,255,255,255,255,255,208,0,0,0,7,255,255,248,0,0,0,0,0,0,0,0,0,0,0,47,255,255,255,255,255,249,0,0,0,2,255,255,253,0,0,0,0,0,0,0,0,0,0,0,191,255,255,255,255,255,255,250,64,0,160,255,255,255,64,0,0,0,0,0,0,0,0,0,0,255,255,255,255,255,255,255,255,249,0,184,127,255,255,192,0,0,0,0,0,0,0,0,0,2,255,255,255,255,255,255,255,255,255,144,190,47,255,255,224,0,0,0,0,0,0,0,0,0,7,255,255,255,255,255,255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
,0,0,0,0,0,0,0,0,0,0,0,0,0,0,0,0,0,0,0,0,0,0,0,0,0,0,0,0,0,0,0,0,0,0,0,0,0,0,0,0,0,0,0,0,0,0,0,0,0,0,0,0,0,0,0,0,0,0,0,0,0,0,0,0,0,0,0,0,0,0,0,0,0,0,0,0,0,0,0,0,0,0,0,0,0,0,0,0,0,0,0,0,0,0,0,0,0,0,0,0,0,0,0,0,0,0,0,0,0,0,0,0,0,0,0,0,0,0,0,0,0,0,0,0,0,0,0,0,0,0,0,0,0,0,0,0,0,0,0,0,0,0,0,0,0,0,0,0,0,0,0,0,0,0,0,0,0,0,0,0,0,0,0,0,0,0,0,0,0,0,0,0,0,0,0,0,0,0,0,0,0,0},
  {0,0,0,0,0,0,0,0,0,0,0,0,0,0,0,0,0,0,0,0,0,0,0,0,0,0,0,0,0,0,0,0,0,0,0,0,0,0,0,0,0,0,0,0,0,0,0,0,0,0,0,0,0,0,0,0,0,0,0,0,0,0,0,0,0,0,0,0,0,0,0,0,0,0,0,0,0,0,0,0,0,0,0,0,0,0,0,0,0,0,0,0,0,0,0,0,0,0,0,0,0,0,0,0,0,0,0,0,0,0,0,0,0,0,0,0,0,0,0,0,0,0,0,0,0,0,0,0,0,0,0,0,0,0,0,0,0,0,0,0,0,0,0,0,0,0,0,0,0,0,0,0,0,0,0,0,0,0,0,0,0,0,0,0,0,0,0,0,0,0,0,0,0,0,0,0,0,0,0,0,0,0,0,0,0,0,0,0,0,0,0,0,0,0,0,0,0,0,0,0,0,0,0,0,0,0,0,0,0,0,0,0,0,0,0,0,0,0,0,0,0,0,0,0,0,0,0,0,0,0,0,0,0,0,0,0,0,0,0,0,0,0,0,0,0,0,0,0,0,0,0,0,0,0,0,0,0,0,0,0,0,0,0,0,0,0,0,0,0,0,0,0,0,0,0,0,0,0,0,0,0,0,0,0,0,0,0,0,0,0,0,0,0,0,0,0,0,0,0,0,0,0,0,0,0,0,0,0,0,0,0,0,0,0,0,0,0,0,0,0,0,0,0,0,0,0,0,0,0,0,0,0,0,0,0,0,0,0,0,0,0,0,0,0,0,0,0,0,0,0,41,0,0,0,0,0,0,0,0,0,0,0,0,0,0,0,0,0,0,0,0,0,0,0,0,63,208,0,0,0,0,0,0,0,0,0,0,0,0,0,0,0,0,1,0,0,0,0,0,0,127,253,0,0,0,0,0,0,0,0,0,0,0,0,0,0,0,6,255,233,0,0,0,0,0,127,255,208,0,0,0,0,0,0,0,0,0,0,0,0,0,1,191,255,255,224,0,0,0,0,127,255,244,0,0,0,0,0,0,0,0,0,0,0,0,0,11,255,255,255,253,0,0,0,0,63,255,254,0,0,0,0,0,0,0,0,0,0,0,0,0,47,255,255,255,255,128,0,0,0,47,255,255,128,0,0,0,0,0,0,0,0,0,0,0,1,255,255,255,255,255,244,0,0,0,31,255,255,224,0,0,0,0,0,0,0,0,0,0,0,3,255,255,255,255,255,253,0,0,0,11,255,255,248,0,0,0,0,0,0,0,0,0,0,0,11,255,255,255,255,255,255,148,0,0,3,255,255,254,0,0,0,0,0,0,0,0,0,0,0,47,255,255,255,255,255,255,255,228,0,209,255,255,255,128,0,0,0,0,0,0,0,0,0,0,63,255,255,255,255,255,255,255,255,128,248,127,255,255,208,0,0,0,0,0,0,0,0,0,0,191,255,255,255,255,255,255,255,255,24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
,0,0,0,0,0,0,0,0,0,0,0,0,0,0,0,0,0,0,0,0,0,0,0,0,0,0,0,0,0,0,0,0,0,0,0,0,0,0,0,0,0,0,0,0,0,0,0,0,0,0,0,0,0,0,0,0,0,0,0,0,0,0,0,0,0,0,0,0,0,0,0,0,0,0,0,0,0,0,0,0,0,0,0,0,0,0,0,0,0,0,0,0,0,0,0,0,0,0,0,0,0,0,0,0,0,0,0,0,0,0,0,0,0,0,0,0,0,0,0,0,0,0,0,0,0,0,0,0,0,0,0,0,0,0,0,0,0,0,0,0,0,0,0,0,0,0,0,0,0,0,0,0,0,0,0,0,0,0,0,0,0,0,0,0,0,0,0,0,0,0,0,0,0,0,0,0,0,0,0},
  {0,0,0,0,0,0,0,0,0,0,0,0,0,0,0,0,0,0,0,0,0,0,0,0,0,0,0,0,0,0,0,0,0,0,0,0,0,0,0,0,0,0,0,0,0,0,0,0,0,0,0,0,0,0,0,0,0,0,0,0,0,0,0,0,0,0,0,0,0,0,0,0,0,0,0,0,0,0,0,0,0,0,0,0,0,0,0,0,0,0,0,0,0,0,0,0,0,0,0,0,0,0,0,0,0,0,0,0,0,0,0,0,0,0,0,0,0,0,0,0,0,0,0,0,0,0,0,0,0,0,0,0,0,0,0,0,0,0,0,0,0,0,0,0,0,0,0,0,0,0,0,0,0,0,0,0,0,0,0,0,0,0,0,0,0,0,0,0,0,0,0,0,0,0,0,0,0,0,0,0,0,0,0,0,0,0,0,0,0,0,0,0,0,0,0,0,0,0,0,0,0,0,0,0,0,0,0,0,0,0,0,0,0,0,0,0,0,0,0,0,0,0,0,0,0,0,0,0,0,0,0,0,0,0,0,0,0,0,0,0,0,0,0,0,0,0,0,0,0,0,0,0,0,0,0,0,0,0,0,0,0,0,0,0,0,0,0,0,0,0,0,0,0,0,0,0,0,0,0,0,0,0,0,0,0,0,0,0,0,0,0,0,0,0,0,0,0,0,0,0,0,0,0,0,0,0,0,0,0,0,0,0,0,0,0,0,0,0,0,0,0,0,0,0,0,0,0,0,0,0,0,0,0,0,0,0,0,0,0,0,0,0,0,0,0,0,0,0,0,0,41,0,0,0,0,0,0,0,0,0,0,0,0,0,0,0,0,0,0,0,0,0,0,0,0,63,228,0,0,0,0,0,0,0,0,0,0,0,0,0,0,0,0,0,0,0,0,0,0,0,63,254,64,0,0,0,0,0,0,0,0,0,0,0,0,0,0,1,175,233,0,0,0,0,0,63,255,208,0,0,0,0,0,0,0,0,0,0,0,0,0,0,111,255,255,228,0,0,0,0,63,255,248,0,0,0,0,0,0,0,0,0,0,0,0,0,2,255,255,255,254,0,0,0,0,47,255,255,64,0,0,0,0,0,0,0,0,0,0,0,0,31,255,255,255,255,208,0,0,0,31,255,255,208,0,0,0,0,0,0,0,0,0,0,0,0,127,255,255,255,255,244,0,0,0,15,255,255,244,0,0,0,0,0,0,0,0,0,0,0,1,255,255,255,255,255,254,0,0,0,7,255,255,253,0,0,0,0,0,0,0,0,0,0,0,3,255,255,255,255,255,255,144,0,0,2,255,255,255,64,0,0,0,0,0,0,0,0,0,0,11,255,255,255,255,255,255,255,144,0,224,191,255,255,192,0,0,0,0,0,0,0,0,0,0,31,255,255,255,255,255,255,255,254,64,189,63,255,255,224,0,0,0,0,0,0,0,0,0,0,63,255,255,255,255,255,255,255,255,244,191,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
0,0,0,0,0,0,0,0,0,0,0,0,0,0,0,0,0,0,0,0,0,0,0,0,0,0,0,0,0,0,0,0,0,0,0,0,0,0,0,0,0,0,0,0,0,0,0,0,0,0,0,0,0,0,0,0,0,0,0,0,0,0,0,0,0,0,0,0,0,0,0,0,0,0,0,0,0,0,0,0,0,0,0,0,0,0,0,0,0,0,0,0,0,0,0,0,0,0,0,0,0,0,0,0,0,0,0,0,0,0,0,0,0,0,0,0,0,0,0,0,0,0,0,0,0,0,0,0,0,0,0,0,0,0,0,0,0,0,0,0,0,0,0,0,0,0,0,0,0,0,0,0,0,0,0,0,0,0,0,0,0,0,0,0,0,0,0,0},
  {0,0,0,0,0,0,0,0,0,0,0,0,0,0,0,0,0,0,0,0,0,0,0,0,0,0,0,0,0,0,0,0,0,0,0,0,0,0,0,0,0,0,0,0,0,0,0,0,0,0,0,0,0,0,0,0,0,0,0,0,0,0,0,0,0,0,0,0,0,0,0,0,0,0,0,0,0,0,0,0,0,0,0,0,0,0,0,0,0,0,0,0,0,0,0,0,0,0,0,0,0,0,0,0,0,0,0,0,0,0,0,0,0,0,0,0,0,0,0,0,0,0,0,0,0,0,0,0,0,0,0,0,0,0,0,0,0,0,0,0,0,0,0,0,0,0,0,0,0,0,0,0,0,0,0,0,0,0,0,0,0,0,0,0,0,0,0,0,0,0,0,0,0,0,0,0,0,0,0,0,0,0,0,0,0,0,0,0,0,0,0,0,0,0,0,0,0,0,0,0,0,0,0,0,0,0,0,0,0,0,0,0,0,0,0,0,0,0,0,0,0,0,0,0,0,0,0,0,0,0,0,0,0,0,0,0,0,0,0,0,0,0,0,0,0,0,0,0,0,0,0,0,0,0,0,0,0,0,0,0,0,0,0,0,0,0,0,0,0,0,0,0,0,0,0,0,36,0,0,0,0,0,0,0,0,0,0,0,0,0,0,0,0,0,0,0,0,0,0,0,0,191,64,0,0,0,0,0,0,0,0,0,0,0,0,0,0,0,0,0,0,0,0,0,0,0,191,244,0,0,0,0,0,0,0,0,0,0,0,0,0,0,0,0,0,0,0,0,0,0,0,191,254,0,0,0,0,0,0,0,0,0,0,0,0,0,0,0,0,0,0,0,0,0,0,0,191,255,128,0,0,0,0,0,0,0,0,0,0,0,0,0,0,0,0,0,0,0,0,0,0,191,255,224,0,0,0,0,0,0,0,0,0,0,0,0,0,1,171,233,0,0,0,0,0,0,127,255,253,0,0,0,0,0,0,0,0,0,0,0,0,0,111,255,255,228,0,0,0,0,0,127,255,254,0,0,0,0,0,0,0,0,0,0,0,0,2,255,255,255,254,0,0,0,0,0,47,255,255,128,0,0,0,0,0,0,0,0,0,0,0,31,255,255,255,255,208,0,0,0,0,31,255,255,224,0,0,0,0,0,0,0,0,0,0,0,127,255,255,255,255,248,0,0,0,7,75,255,255,244,0,0,0,0,0,0,0,0,0,0,1,255,255,255,255,255,254,0,0,0,7,210,255,255,252,0,0,0,0,0,0,0,0,0,0,3,255,255,255,255,255,255,144,0,0,7,245,255,255,254,0,0,0,0,0,0,0,0,0,0,11,255,255,255,255,255,255,254,144,0,7,253,127,255,255,64,0,0,0,0,0,0,0,0,0,31,255,255,255,255,255,255,255,254,64,3,255,111,255,255,128,0,0,0,0,0,0,0,0,0,63,255,255,255,255,25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
0,0,0,0,0,0,0,0,0,0,0,0,0,0,0,0,0,0,0,0,0,0,0,0,0,0,0,0,0,0,0,0,0,0,0,0,0,0,0,0,0,0,0,0,0,0,0,0,0,0,0,0,0,0,0,0,0,0,0,0,0,0,0,0,0,0,0,0,0,0,0,0,0,0,0,0,0,0,0,0,0,0,0,0,0,0,0,0,0,0,0,0,0,0,0,0,0,0,0,0,0,0,0,0,0,0,0,0,0,0,0,0,0,0,0,0,0,0,0,0,0,0,0,0,0,0,0,0,0,0,0,0,0,0,0,0,0,0,0,0,0,0,0,0,0,0,0,0,0,0,0,0,0,0,0,0,0,0,0,0,0,0,0,0,0,0,0,0,0,0,0},
  {0,0,0,0,0,0,0,0,0,0,0,0,0,0,0,0,0,0,0,0,0,0,0,0,0,0,0,0,0,0,0,0,0,0,0,0,0,0,0,0,0,0,0,0,0,0,0,0,0,0,0,0,0,0,0,0,0,0,0,0,0,0,0,0,0,0,0,0,0,0,0,0,0,0,0,0,0,0,0,0,0,0,0,0,0,0,0,0,0,0,0,0,0,0,0,0,0,0,0,0,0,0,0,0,0,0,0,0,0,0,0,0,0,0,0,0,0,0,0,0,0,0,0,0,0,0,0,0,0,0,0,0,0,0,0,0,0,0,0,0,0,0,0,0,0,0,0,0,0,0,0,0,0,0,0,0,0,0,0,0,0,0,0,0,0,0,0,0,0,0,0,0,0,0,0,0,0,0,0,0,0,0,0,0,0,0,0,0,0,0,0,0,0,0,0,0,0,0,0,0,0,0,0,0,0,0,0,0,0,0,0,0,0,0,0,0,0,0,0,0,0,0,0,0,0,0,0,180,0,0,0,0,0,0,0,0,0,0,0,0,0,0,0,0,0,0,0,0,0,0,0,0,255,64,0,0,0,0,0,0,0,0,0,0,0,0,0,0,0,0,0,0,0,0,0,0,1,255,208,0,0,0,0,0,0,0,0,0,0,0,0,0,0,0,0,0,0,0,0,0,0,2,255,248,0,0,0,0,0,0,0,0,0,0,0,0,0,0,0,0,0,0,0,0,0,0,2,255,254,0,0,0,0,0,0,0,0,0,0,0,0,0,0,0,0,0,0,0,0,0,0,2,255,255,128,0,0,0,0,0,0,0,0,0,0,0,0,0,0,0,0,0,0,0,0,0,1,255,255,224,0,0,0,0,0,0,0,0,0,0,0,0,0,5,0,0,0,0,0,0,0,0,255,255,244,0,0,0,0,0,0,0,0,0,0,0,0,22,255,233,0,0,0,0,0,0,0,191,255,252,0,0,0,0,0,0,0,0,0,0,0,1,191,255,255,224,0,0,0,0,0,36,127,255,254,0,0,0,0,0,0,0,0,0,0,0,11,255,255,255,253,0,0,0,0,0,45,47,255,255,64,0,0,0,0,0,0,0,0,0,0,127,255,255,255,255,128,0,0,0,0,63,95,255,255,192,0,0,0,0,0,0,0,0,0,1,255,255,255,255,255,244,0,0,0,0,63,219,255,255,224,0,0,0,0,0,0,0,0,0,7,255,255,255,255,255,253,0,0,0,0,63,227,255,255,240,0,0,0,0,0,0,0,0,0,15,255,255,255,255,255,255,148,0,0,0,47,249,255,255,244,0,0,0,0,0,0,0,0,0,47,255,255,255,255,255,255,255,228,0,0,47,253,191,255,248,0,0,0,0,0,0,0,0,0,127,255,255,255,255,255,255,255,255,128,0,31,255,127,255,252,0,0,0,0,0,0,0,0,0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
,0,0,0,0,0,0,0,0,0,0,0,0,0,0,0,0,0,0,0,0,0,0,0,0,0,0,0,0,0,0,0,0,0,0,0,0,0,0,0,0,0,0,0,0,0,0,0,0,0,0,0,0,0,0,0,0,0,0,0,0,0,0,0,0,0,0,0,0,0,0,0,0,0,0,0,0,0,0,0,0,0,0,0,0,0,0,0,0,0,0,0,0,0,0,0,0,0,0,0,0,0,0,0,0,0,0,0,0,0,0,0,0,0,0,0,0,0,0,0,0,0,0,0,0,0,0,0,0,0,0,0,0,0,0,0,0,0,0,0,0,0,0,0,0,0,0,0,0,0,0,0,0,0,0,0,0,0,0,0,0,0,0,0,0,0,0,0,0,0,0,0,0,0,0,0,0,0,0,0,0,0,0,0,0,0,0,0},
  {0,0,0,0,0,0,0,0,0,0,0,0,0,0,0,0,0,0,0,0,0,0,0,0,0,0,0,0,0,0,0,0,0,0,0,0,0,0,0,0,0,0,0,0,0,0,0,0,0,0,0,0,0,0,0,0,0,0,0,0,0,0,0,0,0,0,0,0,0,0,0,0,0,0,0,0,0,0,0,0,0,0,0,0,0,0,0,0,0,0,0,0,0,0,0,0,0,0,0,0,0,0,0,0,0,0,0,0,0,0,0,0,0,0,0,0,0,0,0,0,0,0,0,0,0,0,0,0,0,0,0,0,0,0,0,0,0,0,0,0,0,0,0,0,0,0,0,0,0,0,0,0,0,0,0,0,0,0,0,0,0,0,0,0,0,0,0,0,0,0,0,0,0,0,0,0,0,0,0,0,0,0,0,0,0,0,0,0,0,0,0,0,0,0,0,0,0,0,0,0,0,0,16,0,0,0,0,0,0,0,0,0,0,0,0,0,0,0,0,0,0,0,0,0,0,0,0,121,0,0,0,0,0,0,0,0,0,0,0,0,0,0,0,0,0,0,0,0,0,0,0,0,191,128,0,0,0,0,0,0,0,0,0,0,0,0,0,0,0,0,0,0,0,0,0,0,0,255,224,0,0,0,0,0,0,0,0,0,0,0,0,0,0,0,0,0,0,0,0,0,0,0,255,248,0,0,0,0,0,0,0,0,0,0,0,0,0,0,0,0,0,0,0,0,0,0,1,255,255,0,0,0,0,0,0,0,0,0,0,0,0,0,0,0,0,0,0,0,0,0,0,0,255,255,128,0,0,0,0,0,0,0,0,0,0,0,0,0,0,0,0,0,0,0,0,0,0,255,255,224,0,0,0,0,0,0,0,0,0,0,0,0,1,85,64,0,0,0,0,0,0,0,255,255,244,0,0,0,0,0,0,0,0,0,0,0,0,191,255,249,0,0,0,0,0,0,0,127,255,253,0,0,0,0,0,0,0,0,0,0,0,27,255,255,255,208,0,0,0,0,0,24,63,255,254,0,0,0,0,0,0,0,0,0,0,0,127,255,255,255,248,0,0,0,0,0,46,47,255,255,64,0,0,0,0,0,0,0,0,0,2,255,255,255,255,255,64,0,0,0,0,47,79,255,255,192,0,0,0,0,0,0,0,0,0,11,255,255,255,255,255,208,0,0,0,0,63,219,255,255,208,0,0,0,0,0,0,0,0,0,47,255,255,255,255,255,249,0,0,0,0,47,247,255,255,240,0,0,0,0,0,0,0,0,0,127,255,255,255,255,255,255,249,64,0,0,47,249,255,255,244,0,0,0,0,0,0,0,0,0,255,255,255,255,255,255,255,255,249,0,0,47,253,191,255,248,0,0,0,0,0,0,0,0,2,255,255,255,255,255,255,255,255,255,144,0,31,255,127,255,252,0,0,0,0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
0,0,0,0,0,0,0,0,0,0,0,0,0,0,0,0,0,0,0,0,0,0,0,0,0,0,0,0,0,0,0,0,0,0,0,0,0,0,0,0,0,0,0,0,0,0,0,0,0,0,0,0,0,0,0,0,0,0,0,0,0,0,0,0,0,0,0,0,0,0,0,0,0,0,0,0,0,0,0,0,0,0,0,0,0,0,0,0,0,0,0,0,0,0,0,0,0,0,0,0,0,0,0,0,0,0,0,0,0,0,0,0,0,0,0,0,0,0,0,0,0,0,0,0,0,0,0,0,0,0,0,0,0,0,0,0,0,0,0,0,0,0,0,0,0,0,0,0,0,0,0,0,0,0,0,0,0,0,0,0,0,0,0,0,0,0,0,0,0,0,0,0,0,0,0,0,0,0,0,0,0,0,0,0,0,0,0,0},
  {0,0,0,0,0,0,0,0,0,0,0,0,0,0,0,0,0,0,0,0,0,0,0,0,0,0,0,0,0,0,0,0,0,0,0,0,0,0,0,0,0,0,0,0,0,0,0,0,0,0,0,0,0,0,0,0,0,0,0,0,0,0,0,0,0,0,0,0,0,0,0,0,0,0,0,0,0,0,0,0,0,0,0,0,0,0,0,0,0,0,0,0,0,0,0,0,0,0,0,0,0,0,0,0,0,0,0,0,0,0,0,0,0,0,0,0,0,0,0,0,0,0,0,0,0,0,0,0,0,0,0,0,0,0,0,0,0,0,0,0,0,0,0,0,0,0,0,0,0,0,0,0,0,0,0,0,0,0,0,0,0,0,0,0,0,0,0,0,0,0,0,0,0,0,0,0,0,0,0,0,0,0,0,0,0,0,0,0,0,0,0,0,0,0,0,0,0,0,0,0,0,0,0,0,0,0,0,0,0,0,0,0,0,0,0,0,0,0,0,0,0,0,0,0,0,0,0,164,0,0,0,0,0,0,0,0,0,0,0,0,0,0,0,0,0,0,0,0,0,0,0,0,254,0,0,0,0,0,0,0,0,0,0,0,0,0,0,0,0,0,0,0,0,0,0,0,1,255,208,0,0,0,0,0,0,0,0,0,0,0,0,0,0,0,0,0,0,0,0,0,0,2,255,244,0,0,0,0,0,0,0,0,0,0,0,0,0,0,0,0,0,0,0,0,0,0,2,255,253,0,0,0,0,0,0,0,0,0,0,0,0,0,0,0,0,0,0,0,0,0,0,2,255,255,64,0,0,0,0,0,0,0,0,0,0,0,0,0,0,0,0,0,0,0,0,0,2,255,255,192,0,0,0,0,0,0,0,0,0,0,0,0,21,165,64,0,0,0,0,0,0,1,255,255,224,0,0,0,0,0,0,0,0,0,0,0,2,255,255,249,0,0,0,0,0,0,0,255,255,248,0,0,0,0,0,0,0,0,0,0,0,47,255,255,255,128,0,0,0,0,0,32,191,255,253,0,0,0,0,0,0,0,0,0,0,1,255,255,255,255,244,0,0,0,0,0,56,127,255,254,0,0,0,0,0,0,0,0,0,0,7,255,255,255,255,254,0,0,0,0,0,62,47,255,255,64,0,0,0,0,0,0,0,0,0,31,255,255,255,255,255,208,0,0,0,0,127,143,255,255,128,0,0,0,0,0,0,0,0,0,127,255,255,255,255,255,249,80,0,0,0,127,219,255,255,208,0,0,0,0,0,0,0,0,0,255,255,255,255,255,255,255,254,64,0,0,127,243,255,255,224,0,0,0,0,0,0,0,0,2,255,255,255,255,255,255,255,255,249,0,0,63,249,255,255,240,0,0,0,0,0,0,0,0,7,255,255,255,255,255,255,255,255,255,144,0,47,253,191,255,244,0,0,0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
0,0,0,0,0,0,0,0,0,0,0,0,0,0,0,0,0,0,0,0,0,0,0,0,0,0,0,0,0,0,0,0,0,0,0,0,0,0,0,0,0,0,0,0,0,0,0,0,0,0,0,0,0,0,0,0,0,0,0,0,0,0,0,0,0,0,0,0,0,0,0,0,0,0,0,0,0,0,0,0,0,0,0,0,0,0,0,0,0,0,0,0,0,0,0,0,0,0,0,0,0,0,0,0,0,0,0,0,0,0,0,0,0,0,0,0,0,0,0,0,0,0,0,0,0,0,0,0,0,0,0,0,0,0,0,0,0,0,0,0,0,0,0,0,0,0,0,0,0,0,0,0,0,0,0,0,0,0,0,0,0,0,0,0,0,0,0,0,0,0,0,0,0,0,0,0,0,0,0,0,0,0,0},
  {0,0,0,0,0,0,0,0,0,0,0,0,0,0,0,0,0,0,0,0,0,0,0,0,0,0,0,0,0,0,0,0,0,0,0,0,0,0,0,0,0,0,0,0,0,0,0,0,0,0,0,0,0,0,0,0,0,0,0,0,0,0,0,0,0,0,0,0,0,0,0,0,0,0,0,0,0,0,0,0,0,0,0,0,0,0,0,0,0,0,0,0,0,0,0,0,0,0,0,0,0,0,0,0,0,0,0,0,0,0,0,0,0,0,0,0,0,0,0,0,0,0,0,0,0,0,0,0,0,0,0,0,0,0,0,0,0,0,0,0,0,0,0,0,0,0,0,0,0,0,0,0,0,0,0,0,0,0,0,0,0,0,0,0,0,0,0,0,0,0,0,0,0,0,0,0,0,0,0,0,0,0,0,0,0,0,0,0,0,0,0,0,0,0,0,0,0,0,0,0,0,0,0,0,0,0,0,0,0,0,0,0,0,0,0,0,0,0,0,0,0,0,0,0,0,0,0,0,0,0,0,0,0,0,0,0,0,0,0,0,0,0,0,0,0,0,0,0,0,0,0,0,0,0,0,0,0,0,0,0,0,0,0,0,0,0,0,0,0,0,0,0,0,0,0,0,40,0,0,0,0,0,0,0,0,0,0,0,0,0,0,0,0,0,0,0,0,0,0,0,0,127,128,0,0,0,0,0,0,0,0,0,0,0,0,0,0,0,0,0,0,0,0,0,0,0,191,244,0,0,0,0,0,0,0,0,0,0,0,0,0,0,0,0,0,0,0,0,0,0,0,191,254,0,0,0,0,0,0,0,0,0,0,0,0,0,0,0,0,0,0,0,0,0,0,0,191,255,128,0,0,0,0,0,0,0,0,0,0,0,0,0,22,165,64,0,0,0,0,0,0,191,255,224,0,0,0,0,0,0,0,0,0,0,0,0,6,255,255,248,0,0,0,0,0,0,127,255,248,0,0,0,0,0,0,0,0,0,0,0,0,127,255,255,255,128,0,0,0,0,0,63,255,254,0,0,0,0,0,0,0,0,0,0,0,2,255,255,255,255,244,0,0,0,0,0,47,255,255,64,0,0,0,0,0,0,0,0,0,0,11,255,255,255,255,254,0,0,0,0,5,31,255,255,192,0,0,0,0,0,0,0,0,0,0,47,255,255,255,255,255,128,0,0,0,11,75,255,255,224,0,0,0,0,0,0,0,0,0,0,191,255,255,255,255,255,249,80,0,0,11,211,255,255,244,0,0,0,0,0,0,0,0,0,1,255,255,255,255,255,255,255,254,80,0,11,246,255,255,252,0,0,0,0,0,0,0,0,0,3,255,255,255,255,255,255,255,255,249,0,11,253,191,255,254,0,0,0,0,0,0,0,0,0,11,255,255,255,255,255,255,255,255,255,144,11,254,63,255,255,0,0,0,0,0,0,0,0,0,15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
,0,0,0,0,0,0,0,0,0,0,0,0,0,0,0,0,0,0,0,0,0,0,0,0,0,0,0,0,0,0,0,0,0,0,0,0,0,0,0,0,0,0,0,0,0,0,0,0,0,0,0,0,0,0,0,0,0,0,0,0,0,0,0,0,0,0,0,0,0,0,0,0,0,0,0,0,0,0,0,0,0,0,0,0,0,0,0,0,0,0,0,0,0,0,0,0,0,0,0,0,0,0,0,0,0,0,0,0,0,0,0,0,0,0,0,0,0,0,0,0,0,0,0,0,0,0,0,0,0,0,0,0,0,0,0,0,0,0,0,0,0,0,0,0,0,0,0,0,0,0,0,0,0,0,0,0,0,0,0,0,0,0,0,0,0,0,0,0,0,0,0,0,0,0,0,0,0,0,0,0,0,0,0,0},
  {0,0,0,0,0,0,0,0,0,0,0,0,0,0,0,0,0,0,0,0,0,0,0,0,0,0,0,0,0,0,0,0,0,0,0,0,0,0,0,0,0,0,0,0,0,0,0,0,0,0,0,0,0,0,0,0,0,0,0,0,0,0,0,0,0,0,0,0,0,0,0,0,0,0,0,0,0,0,0,0,0,0,0,0,0,0,0,0,0,0,0,0,0,0,0,0,0,0,0,0,0,0,0,0,0,0,0,0,0,0,0,0,0,0,0,0,0,0,0,0,0,0,0,0,0,0,0,0,0,0,0,0,0,0,0,0,0,0,0,0,0,0,0,0,0,0,0,0,0,0,0,0,0,0,0,0,0,0,0,0,0,0,0,0,0,0,0,0,0,0,0,0,0,0,0,0,0,0,0,0,0,0,0,0,0,0,0,0,0,0,0,0,0,0,0,0,0,0,0,0,0,0,0,0,0,0,0,0,0,0,0,0,0,0,0,0,0,0,0,0,0,0,0,0,0,0,0,0,0,0,0,0,0,0,0,0,0,0,0,0,0,0,0,0,0,0,0,0,0,0,0,0,0,0,0,0,0,0,0,0,0,0,0,0,0,0,0,0,0,0,0,0,0,0,0,0,0,0,0,0,0,0,0,0,0,0,0,0,0,0,0,0,0,0,0,0,0,0,0,0,0,0,0,0,0,0,0,0,0,0,0,0,0,0,0,0,0,0,0,0,0,0,0,0,0,4,0,0,0,0,0,0,0,0,0,0,0,0,0,0,0,0,0,0,0,0,0,0,0,0,31,144,0,0,0,0,0,0,0,0,0,0,0,0,0,0,0,0,0,0,0,0,0,0,0,47,249,0,0,0,0,0,0,0,0,0,0,0,0,0,0,0,22,165,64,0,0,0,0,0,47,255,64,0,0,0,0,0,0,0,0,0,0,0,0,0,6,255,255,248,0,0,0,0,0,47,255,224,0,0,0,0,0,0,0,0,0,0,0,0,0,127,255,255,255,128,0,0,0,0,47,255,253,0,0,0,0,0,0,0,0,0,0,0,0,2,255,255,255,255,244,0,0,0,0,31,255,255,64,0,0,0,0,0,0,0,0,0,0,0,11,255,255,255,255,254,0,0,0,0,15,255,255,208,0,0,0,0,0,0,0,0,0,0,0,47,255,255,255,255,255,128,0,0,0,11,255,255,244,0,0,0,0,0,0,0,0,0,0,0,191,255,255,255,255,255,249,80,0,0,3,255,255,252,0,0,0,0,0,0,0,0,0,0,1,255,255,255,255,255,255,255,254,144,0,146,255,255,254,0,0,0,0,0,0,0,0,0,0,3,255,255,255,255,255,255,255,255,249,0,244,191,255,255,64,0,0,0,0,0,0,0,0,0,11,255,255,255,255,255,255,255,255,255,144,253,63,255,255,208,0,0,0,0,0,0,0,0,0,15,255,255,255,255,25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
0,0,0,0,0,0,0,0,0,0,0,0,0,0,0,0,0,0,0,0,0,0,0,0,0,0,0,0,0,0,0,0,0,0,0,0,0,0,0,0,0,0,0,0,0,0,0,0,0,0,0,0,0,0,0,0,0,0,0,0,0,0,0,0,0,0,0,0,0,0,0,0,0,0,0,0,0,0,0,0,0,0,0,0,0,0,0,0,0,0,0,0,0,0,0,0,0,0,0,0,0,0,0,0,0,0,0,0,0,0,0,0,0,0,0,0,0,0,0,0,0,0,0,0,0,0,0,0,0,0,0,0,0,0,0,0,0,0,0,0,0,0,0,0,0,0,0,0,0,0,0,0,0,0,0,0,0,0,0,0,0,0,0,0,0,0,0,0,0,0,0,0,0,0,0,0,0,0,0,0},
  {0,0,0,0,0,0,0,0,0,0,0,0,0,0,0,0,0,0,0,0,0,0,0,0,0,0,0,0,0,0,0,0,0,0,0,0,0,0,0,0,0,0,0,0,0,0,0,0,0,0,0,0,0,0,0,0,0,0,0,0,0,0,0,0,0,0,0,0,0,0,0,0,0,0,0,0,0,0,0,0,0,0,0,0,0,0,0,0,0,0,0,0,0,0,0,0,0,0,0,0,0,0,0,0,0,0,0,0,0,0,0,0,0,0,0,0,0,0,0,0,0,0,0,0,0,0,0,0,0,0,0,0,0,0,0,0,0,0,0,0,0,0,0,0,0,0,0,0,0,0,0,0,0,0,0,0,0,0,0,0,0,0,0,0,0,0,0,0,0,0,0,0,0,0,0,0,0,0,0,0,0,0,0,0,0,0,0,0,0,0,0,0,0,0,0,0,0,0,0,0,0,0,0,0,0,0,0,0,0,0,0,0,0,0,0,0,0,0,0,0,0,0,0,0,0,0,0,0,0,0,0,0,0,0,0,0,0,0,0,0,0,0,0,0,0,0,0,0,0,0,0,0,0,0,0,0,0,0,0,0,0,0,0,0,0,0,0,0,0,0,0,0,0,0,0,0,0,0,0,0,0,0,0,0,0,0,0,0,0,0,0,0,0,0,0,0,0,0,0,0,0,0,0,0,0,0,0,0,0,0,0,0,0,0,0,0,0,0,0,0,0,0,0,0,0,0,0,0,0,0,0,0,0,0,0,0,0,0,0,0,0,0,0,0,0,0,0,0,0,0,80,0,0,0,0,0,0,0,0,0,0,0,0,0,0,0,0,0,0,0,0,0,0,0,0,190,64,0,0,0,0,0,0,0,0,0,0,0,0,0,0,0,22,165,64,0,0,0,0,0,191,244,0,0,0,0,0,0,0,0,0,0,0,0,0,0,6,255,255,248,0,0,0,0,0,191,254,0,0,0,0,0,0,0,0,0,0,0,0,0,0,111,255,255,255,128,0,0,0,0,191,255,208,0,0,0,0,0,0,0,0,0,0,0,0,1,255,255,255,255,244,0,0,0,0,191,255,244,0,0,0,0,0,0,0,0,0,0,0,0,11,255,255,255,255,254,0,0,0,0,127,255,254,0,0,0,0,0,0,0,0,0,0,0,0,47,255,255,255,255,255,128,0,0,0,63,255,255,128,0,0,0,0,0,0,0,0,0,0,0,127,255,255,255,255,255,249,80,0,0,47,255,255,224,0,0,0,0,0,0,0,0,0,0,1,255,255,255,255,255,255,255,254,64,0,15,255,255,244,0,0,0,0,0,0,0,0,0,0,2,255,255,255,255,255,255,255,255,249,0,71,255,255,253,0,0,0,0,0,0,0,0,0,0,7,255,255,255,255,255,255,255,255,255,144,209,255,255,255,0,0,0,0,0,0,0,0,0,0,15,255,255,255,255,255,255,25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
0,0,0,0,0,0,0,0,0,0,0,0,0,0,0,0,0,0,0,0,0,0,0,0,0,0,0,0,0,0,0,0,0,0,0,0,0,0,0,0,0,0,0,0,0,0,0,0,0,0,0,0,0,0,0,0,0,0,0,0,0,0,0,0,0,0,0,0,0,0,0,0,0,0,0,0,0,0,0,0,0,0,0,0,0,0,0,0,0,0,0,0,0,0,0,0,0,0,0,0,0,0,0,0,0,0,0,0,0,0,0,0,0,0,0,0,0,0,0,0,0,0,0,0,0,0,0,0,0,0,0,0,0,0,0,0,0,0,0,0,0,0,0,0,0,0,0,0,0,0,0,0,0,0,0,0,0,0,0,0,0,0,0,0,0,0,0,0,0,0,0,0,0,0,0,0,0,0,0},
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
