bruc3van/agent-buddy-esp32/agent_buddy/QspiFast.h

#pragma once
// 基于 Arduino_GFX 的 Arduino_ESP32QSPI（BSD 授权）修改：writePixels 改为双缓冲异步 DMA，并在发送时顺带做屏幕校色

#include "Arduino_DataBus.h"

#if defined(ESP32) && (CONFIG_IDF_TARGET_ESP32 || CONFIG_IDF_TARGET_ESP32S2 || CONFIG_IDF_TARGET_ESP32S3 || CONFIG_IDF_TARGET_ESP32C2 || CONFIG_IDF_TARGET_ESP32C3 || CONFIG_IDF_TARGET_ESP32C6 || CONFIG_IDF_TARGET_ESP32H2 || CONFIG_IDF_TARGET_ESP32P4 || CONFIG_IDF_TARGET_ESP32C5)
#include <driver/spi_master.h>

#define FAST_CHUNK 8192  // 刷屏每块像素数（16KB，正好在 max_transfer_sz 以内）

#ifndef ESP32QSPI_MAX_PIXELS_AT_ONCE
#define ESP32QSPI_MAX_PIXELS_AT_ONCE 1024
#endif
#ifndef ESP32QSPI_FREQUENCY
#define ESP32QSPI_FREQUENCY 40000000
#endif
#ifndef ESP32QSPI_SPI_MODE
#define ESP32QSPI_SPI_MODE SPI_MODE0
#endif
#ifndef ESP32QSPI_SPI_HOST
#define ESP32QSPI_SPI_HOST SPI2_HOST
#endif
#ifndef ESP32QSPI_DMA_CHANNEL
#define ESP32QSPI_DMA_CHANNEL SPI_DMA_CH_AUTO
#endif

class QspiFast : public Arduino_DataBus
{
public:
  QspiFast(
      int8_t cs, int8_t sck, int8_t mosi, int8_t miso, int8_t quadwp, int8_t quadhd, bool is_shared_interface = false); // Constructor

  bool begin(int32_t speed = GFX_NOT_DEFINED, int8_t dataMode = GFX_NOT_DEFINED) override;
  void beginWrite() override;
  void endWrite() override;
  void writeCommand(uint8_t) override;
  void writeCommand16(uint16_t) override;
  void writeCommandBytes(uint8_t *data, uint32_t len) override;
  void write(uint8_t) override;
  void write16(uint16_t) override;

  void writeC8D8(uint8_t c, uint8_t d) override;
  void writeC8D16(uint8_t c, uint16_t d) override;
  void writeC8D16D16(uint8_t c, uint16_t d1, uint16_t d2) override;
  void writeC8D16D16Split(uint8_t c, uint16_t d1, uint16_t d2) override;

  void writeC8Bytes(uint8_t c, uint8_t *data, uint32_t len);

  void writeRepeat(uint16_t p, uint32_t len) override;
  void writePixels(uint16_t *data, uint32_t len) override;
  void write16bitBeRGBBitmapR1(uint16_t *bitmap, int16_t w, int16_t h) override;

  void batchOperation(const uint8_t *operations, size_t len) override;
  void writeBytes(uint8_t *data, uint32_t len) override;

  void writeIndexedPixels(uint8_t *data, uint16_t *idx, uint32_t len) override;
  void writeIndexedPixelsDouble(uint8_t *data, uint16_t *idx, uint32_t len) override;
  void writeYCbCrPixels(uint8_t *yData, uint8_t *cbData, uint8_t *crData, uint16_t w, uint16_t h) override;

protected:
private:
  GFX_INLINE void CS_HIGH(void);
  GFX_INLINE void CS_LOW(void);
  GFX_INLINE void POLL_START();
  GFX_INLINE void POLL_END();

  int8_t _cs, _sck, _mosi, _miso, _quadwp, _quadhd;
  bool _is_shared_interface;

  PORTreg_t _csPortSet; ///< PORT register for chip select SET
  PORTreg_t _csPortClr; ///< PORT register for chip select CLEAR
  uint32_t _csPinMask;  ///< Bitmask for chip select

  spi_device_handle_t _handle;
  spi_transaction_ext_t _spi_tran_ext;
  spi_transaction_t *_spi_tran;

  union
  {
    uint8_t *_buffer;
    uint16_t *_buffer16;
    uint32_t *_buffer32;
  };
  uint16_t *_fast[2] = {nullptr, nullptr};  // 刷屏用的两块大 DMA 缓冲（双缓冲：一块发送时准备另一块）
  spi_transaction_ext_t _fastTr[2];
  union
  {
    uint8_t *_2nd_buffer;
    uint16_t *_2nd_buffer16;
    uint32_t *_2nd_buffer32;
  };
};

#endif // #if defined(ESP32) && (CONFIG_IDF_TARGET_ESP32 || CONFIG_IDF_TARGET_ESP32S2 || CONFIG_IDF_TARGET_ESP32S3 || CONFIG_IDF_TARGET_ESP32C2 || CONFIG_IDF_TARGET_ESP32C3 || CONFIG_IDF_TARGET_ESP32C6 || CONFIG_IDF_TARGET_ESP32H2 || CONFIG_IDF_TARGET_ESP32P4 || CONFIG_IDF_TARGET_ESP32C5)
