bruc3van/agent-buddy-esp32/(commit log)

2026-10-31 Agent Buddy：桌面 AI 编程伙伴（ESP32-S3 像素屏）
    把 Claude Code、Codex、DeepSeek Harness 的工作状态和额度显示在一块 4.3 寸 ESP32-S3（JC4827W543）触摸屏上。
    - agent_buddy/：固件，画面、触摸、声音、雷达、Wi-Fi 链路
    - bridge/：电脑端守护进程和 buddy 管理工具，接收 hooks 和 statusline，读取 magpie 网关
    - firmware/：预编译固件；setup.sh / setup.cmd 一键配置
    - case/：3D 打印外壳；promo/：宣传片脚本；docs/：使用手册和无线通讯方案
    [1-前框-黑.stl, 2-机身-深灰.stl, 3-后盖-深灰.stl, 4-支架-黑.stl, 外壳预览.blend]
2026-10-31 外壳：删掉两张过时的预览图
    sheet.png 和 front-crop.png 是 10-25 的旧图，model.py 不再生成，也没有地方引用。
2026-10-31 外壳：前框改成压边、机身减薄 10mm、麦克风圆环改纯圆
    - 前框盖住玻璃四边：开窗 101×58mm，以显示区为中心、每边比显示区大 2mm，正面倒角 0.5mm；背面挖放玻璃的凹槽（每边留 0.6mm，上沿多让 2.5mm 给排线），屏幕只凹进 1.1mm
    - 按实测改玻璃 105×66mm、黑边上 8 下 4 左右 4、STANDOFF 5mm；板子跟着后移 1.1mm、上移 1mm，柱子加长到 4.1mm，机身高 87→89mm
    - 前框下巴刻字改成 Agent Buddy
    - 机身右侧开口下沿上收 4mm（SIDE_BOT_UP）
    - 机身深度 45→35mm，支架和底板不变；后盖卡扣横向错开到 x=±21 / ±34，不和前框卡扣相撞
    - 麦克风圆环去掉泪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
    [1-前框-黑.stl, 2-机身-深灰.stl, 3-后盖-深灰.stl, 4-支架-黑.stl, 外壳预览.blend]
2026-10-31 外壳：加一套米白 × Claude 橙配色，README 并排展示两套配色
    - 前框、后盖、支架米白，机身 Claude 橙（#D97757，和屏幕上 Clawd 同色）；同一套 STL，只换耗材
    - 两套配色都用 Blender 渲染了同角度的预览图（theme-classic / theme-cream），米白款另有三视图
    - README 中英文：外壳单独一节并排放两套配色，实拍改成一行三张
    - 打印说明加配色表和各色用量，提醒米白和橙色用哑光 PLA
2026-10-31 外壳预览：两套配色都改成三视图，米白款压低曝光
    - 经典黑灰和米白 × Claude 橙都渲染正面、左侧、背面三视图，同一套灯光和曝光
    - 曝光从 -0.2 降到 -0.7，米白不再发白、能看出暖色；屏幕自发光和右侧补光相应调亮
    - README 中英文改成上下两张三视图，打印说明的配色一节也放两张
2026-10-31 README：工作原理改成 mermaid 流程图
    原来的字符画在 GitHub 上一行放不下，要横向滚动才看得全。改成 flowchart：电脑里 Claude Code / Codex / DeepSeek Harness 经 hooks、magpie 经只读接口汇到 bridge，再经 USB 或 Wi-Fi 发给屏幕上的固件。中英文同步。
2026-11-01 电池：低电量保护，快没电时深睡，不再反复重启滴滴响
    - 电池快没电时，一开屏幕和 Wi-Fi 升压芯片就扛不住，板子反复掉电重启，每次重启喇叭都响一声
    - setup 第一步先量电压（屏幕、喇叭、Wi-Fi 都还没上电），低于 3.45V 就关背光、深睡，每分钟醒来量一次；插上 USB 读数回到 4.2V 左右就正常开机
    - 运行中平滑后的电压低于 3.30V 也深睡；开机前 15 秒不判断，等平滑稳定
    - 更新预编译固件
2026-11-01 外壳：.blend 预览融并三角面，model.py 输出 Agent-Buddy-外壳.zip 打印包
    - blender_scene.py 导入零件后做有限融并（1°），共面三角形合成大面，编辑模式里不再满屏细长三角形；支架 172 个三角面 → 54 个面，STL 不变
    - 保存 .blend 时不留 .blend1 备份
    - model.py 最后打包 case/Agent-Buddy-外壳.zip：打印说明、组装清单、STL、预览图和 .blend
    - .gitignore 删掉旧打印包副本目录和根目录旧压缩包的条目（文件已清理）
    [外壳预览.blend]
2026-11-01 README：说明转接线、杜邦线整份买，实际只用到一小部分
    - 转接线一份 5 条，实际只用到 1 条；合计价格旁补一句说明
    - 中英文同步
2026-11-01 宣传片：修黑边闪、开窗亮条和米白配色色差，出 1 分钟成品版和 DIY 版
    - scene.py：屏幕模组后移，正面不再和玻璃共面，黑边不再逐帧闪动
    - scene.py：黑 PLA 改哑光、关光线追踪，镜头转过来时开窗倒角不再出亮条
    - scene.py：新增双色定格镜头，Standard 视图变换加正面补光，米白和 Claude 橙对齐预览图颜色
    - edit.py：三种剪辑（完整版 2:44、1 分钟成品版、1 分钟 DIY 版），切点卡音乐节拍；字幕放大，结尾两套配色并排
    - edit.py：去掉语音播报只留蜂鸣提示，换掉有色差的屏幕照片，「自己画外壳」改用 Blender 界面截图
    - blender_shot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
2026-11-02 电池：记录续航，低电量关过一次后要充到 3.80V 才开机
    - 原来静置后电压能弹回 3.45V 以上，开机一带载又掉电重启，滴滴声停不下来：低电量关机后在 NVS 记一笔，之后要 3.80V（充上电 / 插 USB）才开机
    - 靠电池开机没撑过 20 秒就掉电（欠压复位，或连着两次）也当成电池扛不住，同样处理
    - 续航：从拔掉 USB 起累计靠电池运行的时间，到低电量关机记成「上次续航」，连同起始电量；每分钟存一次，中途重启接着算，插回 USB 作废
    - 设置 → 关于 →「电源」显示「本次已用」和「上次续航」
    - 注明充电 / 升压芯片是 IP5306：SW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
2026-11-02 Codex：动作照桌面版默认宠物重做
    - 思考和干活一样坐下来抱笔记本敲（官方没有单独的思考动作）
    - 待命：>_ 和闭眼慢慢眨，按桌面版放慢 6 倍；等确认恢复原速
    - 完成时跳起来双手举高；出错时叉腰和抱头交替
    - 被点：官方 jumping，下蹲、起跳、举手、落地，连跳 3 下；欢迎回来举左手挥两下
    - 头顶的 z 只在真睡着时飘，不再跟着闭眼的眨眼帧出现
    - 使用手册同步
2026-11-02 DeepSeek：小鲸鱼尾巴加粗，尾鳍改成大 V 字
    - 尾柄从 2 格加粗到 4 格，背部顺着过渡上去，不再突然收口
    - 尾鳍改成 5 行高（DS_FLUKE_ROWS），翘起时是两片带暗面的大叶，放平时也加宽
    - 背部降一行给尾鳍腾地方；喷水口、睡觉的 z、浮上水面的深度跟着下移一行
    - 更新预编译固件（含本次电池、Codex 改动）
2026-11-02 DeepSeek 尾巴改成往后伸；Codex、小鲸鱼也对声音有反应
    - 小鲸鱼：尾柄顺着身子往后伸、上下拍水，尾鳍按拍水方向上翘 / 下压 / 放平；只在鱼缸里低头下潜时才把尾巴竖起来甩出水面（同 logo）
    - 贴图加宽到 36 列（DS_W）：身子一张 + 尾巴四帧（DS_TAIL）；鱼缸游动范围、尾巴后的泡泡、星星和汗滴的位置跟着调
    - 声音反应同 Clawd（buddyReact，只在待命 / 睡觉时）：敲桌子 / 大声响吓一跳冒感叹号，放音乐跟着节拍摇，有人说话安静听，打字时 Codex 抱笔记本陪敲、鲸鱼跟着点头
    - 感叹号抽成 drawBang，三个角色共用
    - 更新预编译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
2026-11-02 Claude：Clawd 动作照官方逐帧重画，气泡改成深色像素风
    - 新增 ui_clawd.ino：待命眼睛转一圈、思考托腮冒蓝色对话泡、干活侧身敲笔记本、完成举手蹦起来、出错皱眉垮下去摇头，照 Claude 桌面端官方 Clawd 动画
    - 首页场景和 Buddy 页共用这套动作；首页干活时对着显示器敲
    - 对话气泡统一成深色底、2px 细边、阶梯小尾巴，不再是大面积白底
    - 调试：/ui?cmode=N 强制显示某个状态 15 秒
    - 手册同步说明，更新预编译固件
2026-11-03 Clawd：Buddy 页完成时跳低一点，举手不再盖住标签栏
2026-11-03 界面评审：各页细节打磨，数据口径统一，Buddy 页显示具体在做什么
    界面
    - 额度颜色统一（>50 绿 / >20 黄 / 其余红），数量改成小角标，长列表加滚动条
    - 账号默认打码（bru***@域名），设置 → 界面可显示完整账号；首页 X 账号可经 /ui?handle= 修改
    - 路由页空状态改成打盹的喜鹊；Agent / 服务方框名字放不下时跑马灯
    - 待机时钟每张卡加额度条和「今天完成 N 个」；Wi-Fi 扫描中、雷达量程、设置开关等细节
    - Clawd 思考气泡在 Buddy 页不再被标签栏挡住；首页场景 Clawd 放大一号
    数据
    - magpie 首页卡片、底栏、路由页的「今天」与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
2026-11-03 固件清单：构建信息指向 44b445b
2026-11-03 排行页、三张 Agent 卡、锁屏三列，状态栏和设置页做减法
    首页
    - 底栏改成 Claude / Codex / DeepSeek 固定三张卡：状态 + 用时、额度（DeepSeek 是余额），等你确认时边框闪
    - 状态栏只留产品标（像素对话框笑脸）、Agent Buddy、齿轮、日期时间；电量低、Wi-Fi 断开、麦克风没开、有人靠近才出现提示
    - 去掉 X 账号和顶栏花费；显示器干活时显示具体命令；删掉卡片模式首页
    magpie
    - Agent 页改成排行：按花费列出各 Agent 的次数、token、失败数，时间段和用量页共用
    - bridge 从用量接口的按 Agent 汇总生成排行（mk）
    锁屏
    - 时钟下面改成三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
2026-11-03 README、使用手册：按新界面更新说明和配图
    - 截图换成 10 张：新增 DeepSeek、排行、待机时钟、设置 · 连接，去掉已不存在的 Agent 页和设置 · 电脑
    - 重录首页动图 hero.gif
    - 功能说明、截图说明、配对步骤（设置 → 连接）同步，英文版一起改
    - 使用手册：页面概览、状态栏、设置页五个分区、Buddy 页状态卡、magpie 四页、待机时钟、通知、电池、雷达入口、调试参数
    - 无线通讯方案里的菜单路径改成 设置 → 连接
2026-11-03 固件：用干净的工作区重新编译，清单指向 133f42b
2026-11-03 状态栏换成线框齿轮，和产品标同线宽；「桥接程序」改称「桥接」
2026-11-03 固件：用干净的工作区重新编译，清单指向 adfca1c
2026-11-03 会话数只数正在跑的：空会话、DeepSeek 子任务不再算；版本升到 v4.2
2026-11-03 固件 v4.2
2026-11-03 宣传片换成固件 v4.2 的新界面
    录屏改用新的「排行」页和「连接」页，替换原来的 Agent 页和电脑设置页。连接页的电脑名和底部露出的 Wi-Fi 名打码，路由页已经没有隐私信息，去掉了它的打码。
    新增 render_v4.sh，用来重渲全部 3D 镜头、重做封面并导出三个版本。
2026-11-04 宣传片：背景光不再跟着运镜扫动，雷达不卡，路由页打码
    灯光挂到灯架上，跟着相机的方位角转（以镜头中点为准，各镜头光感不变），背后轮廓光照在地上的光斑不再扫过背景。转台和开场转得多，压低轮廓灯在前框、玻璃上的高光。
    雷达录到 4 秒多以后板子发帧变慢，贴图只取前 4 秒，正好扫一圈，循环接得上。
    路由页重录了经过网关的请求，账号邮箱打码。新增 render_v5.sh 重渲受影响的镜头并重新出片。
2026-11-04 DeepSeek 气泡换成玻璃泡，图标统一成 DeepSeek 蓝：子智能体改成鲸鱼小队
2026-11-04 修复 7 处问题：子任务压过完成状态、路由列表文字裁剪、切换电脑重复计数等
    - bridge：DeepSeek 子任务只在主会话之后还有新事件时参与选状态，主任务 Stop 后立即显示已完成
    - 固件：文字缓存默认下边界不再固定 272，路由列表缓存图后半部分文字正常显示
    - 「今天完成」按 bridge 进程编号（bi）分别记起点，切换电脑不再重复累计
    - Codex hooks：按解析后的命令判断是否旧路径，清理后重新统计已装事件，不再误删全部
    - 路由页请求列表、服务方节点遵守账号打码设置；bridge 截断时不把邮箱截在 @ 前面
    - 新配对请求到来时「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
    [agent_bridge.py, agent_buddy.ino, buddy.py, hw_state.h, net_link.ino, ui_pixel.ino, ui_scene.ino, ui_settings.ino]
2026-11-04 固件版本升到 v4.3
2026-11-04 固件 v4.3
2026-11-04 Codex 异步提问也提示「等你回复」；点额度卡立即刷新
    - bridge：会话调用 request_user_input(_async) 后记下问题，回答前一直算等你回复，后续事件和另一个会话都压不住
    - 点 Buddy 页的额度卡 / DeepSeek 余额卡：板子发 QREF，bridge 调 magpie quotas/refresh 并立刻重读额度，卡片标题显示「正在刷新」
    - Codex 多账号：改成点 5 小时卡底行的账号名切换账号
    [agent_bridge.py, agent_buddy.ino, hw_state.h, ui_deepseek.ino, ui_pixel.ino]
2026-11-04 固件：用干净的工作区重新编译，清单指向 61be1b1
2026-11-05 切换 Codex 账号更灵敏：当场换账号、点下去就有反馈
    - bridge：收到 CXACC 直接从内存里的账号换好，不再等 magpie 循环、不再触发全量重发
    - 板子：点下去马上显示「切换中」；5 小时卡下半部分都算切账号
    - 账号一行放不下时先去掉邮箱域名，「· 自动 / 手选」一直保留
2026-11-05 固件：用干净的工作区重新编译，清单指向 359a5ad
2026-11-05 README：实拍加入装好外壳的成品图；原图放 photos-raw 不入库
2026-11-05 外壳：机身右侧 USB 开口缩小成封闭方孔
    前后宽从 16 改成 10mm，前口留 2.1mm 窄边，高度 20mm 不变。
    前框 STL 不重新生成：Windows 上字体不同，刻字字形会变。
    [2-机身-深灰.stl, 外壳预览.blend]
2026-11-06 电池：低电量时压住功放引脚，减少喇叭蜂鸣
    - 功放 NS4168 没有使能脚，I2S 三根脚悬空会放大噪声：启动第一步和深睡前都拉低并锁住，确定开机才放开
    - 掉过电后，读数 ≤ 2.8V 不再放行开机；没有掉电记录时照常开机，但计入失败次数
    - 开机量电压改成读 5 次取中位数，避开纹波
    - 电压低于 3.45V 喇叭不再出声，运行中深睡前先停掉音频
    - 靠电池时记录每次上电的复位原因和电压，插回 USB 后以 BATTRACE 打印到 bridge 日志
    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
2026-11-06 触摸：只读芯片标记过的新数据，修复滑动被切碎
    - TAMC_GT911 不看「数据就绪」位，读得比芯片更新快时把空数据当成抬手，滑动被切碎，一次点击可能触发两次
    - 新增 hw_touch.ino，自己读 GT911：有新数据才更新手指状态，按着 150ms 没数据才当成抬手
    - 开机不再写配置刷新标志（旧库的校验和用了未初始化的变量），只有分辨率不对才写，校验和重新算
    - 硬件扫描多打印一行触摸芯片信息，方便对照不同批次的板子
    - 去掉 TAMC_GT911 依赖，README、使用手册同步
    [agent_buddy.ino, buddy.py, hw_scan.ino, hw_touch.ino]
2026-11-08 关机：设置页加关机，插 USB 自动开机；深睡加防过放
    - 设置页左栏最下面加「关机」，点了弹确认框；关屏、停音频和 Wi-Fi，屏幕驱动和触摸芯片也进休眠，然后深睡
    - 关机后每 3 秒醒来量电压，和上次读数比跳高了才看 USB 主机的 SOF，有就开机；只插充电头时跳高后 ≥ 4.25V 也开机
    - 关机时插着 USB：要先拔掉再插上才会开机；按 RST 随时开机
    - 防过放：关机和低电量深睡都按电压少醒，低于 3.50V 最多 5 分钟醒一次，低于 3.30V 不再醒，只能按 RST
    - 只用 USB 供电：上电时电池读数偏低但插着电脑，照常开机，不当成低电量
    -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
2026-11-08 固件版本升到 v4.4
2026-11-08 固件 v4.4
