bruc3van/agent-buddy-esp32/(notices)

Notices in the files:
README.md:
License: MIT
